Eviper01/MAX7000CPU-GEN3/S3-Kicad/S3_Schematic.html

# E:\Libraries\Documents\MAX7000CPU-GEN3\S3-Kicad\S3_Schematic.sch

9/11/2021 22:57:02

Eeschema (5.1.10)-1

Component Count:364

Ref | Qnty | Value | Part | Footprint | Description | Vendor
C1, C2 | 2 | 32p | Device:C | Capacitor_SMD:C_0805_2012Metric | Unpolarized capacitor
C3, C4, C5, C6, C7, C8, C9, C10, C11, C12, C13, C14, C15, C16, C17, C18, C19, C20, C21, C22, C23, C24, C25, C26, C27, C28, C29, C30, C31, C32, C33, C34, C35, C36, C37, C38, C39, C40, C41, C42, C43, C44, C45, C46, C47, C48, C49, C50, C51, C52, C53, C54, C55, C56, C57, C58, C59, C60, C61, C62, C63, C64, C65, C66, C67, C68, C69, C70, C71, C72, C73, C74, C75, C76, C77, C78 | 76 | 100n | Device:C | Capacitor_SMD:C_0805_2012Metric | Unpolarized capacitor
D1, D2, D3, D4, D5, D6, D7, D8, D9, D10, D11, D12, D13, D14, D15, D16, D17, D18, D19, D20, D21, D22, D23, D24, D25, D26, D27, D28, D29, D30, D31, D32, D33, D34, D35, D36, D37, D38, D39, D40, D41, D42, D43, D44, D45, D46, D47, D48, D49, D50, D51, D52, D53, D54, D55, D56 | 56 | LED | Device:LED | LED_SMD:LED_0805_2012Metric | Light emitting diode
J1 | 1 | Conn_02x04_Counter_Clockwise | Connector_Generic:Conn_02x04_Counter_Clockwise | Connector_PinHeader_2.54mm:PinHeader_2x04_P2.54mm_Vertical | Generic connector, double row, 02x04, counter clockwise pin numbering scheme (similar to DIP packge numbering), script generated (kicad-library-utils/schlib/autogen/connector/)
J2, J3, J11 | 3 | Conn_01x02 | Connector_Generic:Conn_01x02 | Connector_PinHeader_2.54mm:PinHeader_1x02_P2.54mm_Vertical | Generic connector, single row, 01x02, script generated (kicad-library-utils/schlib/autogen/connector/)
J4, J5 | 2 | Conn_01x04 | Connector_Generic:Conn_01x04 | Connector_PinHeader_2.54mm:PinHeader_1x04_P2.54mm_Vertical | Generic connector, single row, 01x04, script generated (kicad-library-utils/schlib/autogen/connector/)
J6 | 1 | Conn_01x03 | Connector_Generic:Conn_01x03 | Connector_PinHeader_2.54mm:PinHeader_1x03_P2.54mm_Vertical | Generic connector, single row, 01x03, script generated (kicad-library-utils/schlib/autogen/connector/)
J7 | 1 | Conn_02x16_Odd_Even | Connector_Generic:Conn_02x16_Odd_Even | Connector_PinHeader_2.54mm:PinHeader_2x16_P2.54mm_Vertical | Generic connector, double row, 02x16, odd/even pin numbering scheme (row 1 odd numbers, row 2 even numbers), script generated (kicad-library-utils/schlib/autogen/connector/)
J8, J9, J10 | 3 | Conn_01x16 | Connector_Generic:Conn_01x16 | Connector_PinHeader_2.54mm:PinHeader_1x16_P2.54mm_Vertical | Generic connector, single row, 01x16, script generated (kicad-library-utils/schlib/autogen/connector/)
R1, R2, R3, R4, R5, R6, R7, R8, R9, R10, R13, R14, R19, R20, R25, R26, R45, R46, R49, R50, R61, R64, R65, R66, R67, R68, R69, R70, R71, R72, R73, R74, R75, R76, R77, R78, R79, R80, R81, R82, R83, R84, R85, R86, R87, R88, R89, R100, R102, R103, R109, R110, R111, R112, R113, R114, R115, R116, R117, R118, R119, R120, R121, R122, R123, R124, R125, R126, R127, R128, R129, R130, R131, R132, R133, R134, R135, R136, R137, R138, R139, R140, R141, R142, R143, R144, R145, R146, R147, R148, R149, R150, R151, R152, R153 | 95 | 50K | Device:R | Resistor_SMD:R_0805_2012Metric | Resistor
R11 | 1 | 2.2M | Device:R | Resistor_SMD:R_0805_2012Metric | Resistor
R12 | 1 | 1k | Device:R | Resistor_SMD:R_0805_2012Metric | Resistor
R15, R16, R17, R18, R21, R22, R23, R24, R27, R28, R29, R30, R31, R32, R33, R34, R35, R36, R37, R38, R39, R40, R41, R42, R43, R44, R47, R48, R51, R52, R53, R54, R55, R56, R57, R58, R59, R60, R62, R63, R90, R91, R92, R93, R94, R95, R96, R97, R98, R99, R101, R104, R105, R106, R107, R108 | 56 | 330 | Device:R | Resistor_SMD:R_0805_2012Metric | Resistor
U1 | 1 | SN74LVC1GX04DCKR | Gen3Parts:SN74LVC1GX04DCKR | Package_TO_SOT_SMD:SOT-363_SC-70-6_Handsoldering | Crystal Oscillator Driver
U2, U4, U6, U8, U10, U13, U14, U15, U16, U22, U23, U28, U29, U47, U48, U49, U50, U51, U52, U53, U54, U55, U56, U57, U58, U59, U60, U61, U62 | 29 | 74HC541 | 74xx:74LS541 | Package_SO:TSSOP-20_4.4x6.5mm_P0.65mm | 8-bit Buffer/Line Driver 3-state outputs
U3, U5, U7, U9, U11, U31, U32, U33, U34, U35, U36, U37, U38, U39, U40, U41, U42, U43, U44, U45, U46 | 21 | 74HC574 | S3_Schematic-rescue:74LS573-74xx-MAX7000CPU-Gen2-rescue | Package_SO:TSSOP-20_4.4x6.5mm_P0.65mm
U12, U65 | 2 | SST39VF800A-70-4C-EKE | Gen3Parts:SST39VF800A-70-4C-EKE | Package_SO:TSOP-I-48_18.4x12mm_P0.5mm | 2.7 to 3.6V 8Mbit Multi-Purpose Flash
U17 | 1 | 74HC00 | 74xx:74HC00 | Package_SO:TSSOP-14_4.4x5mm_P0.65mm | quad 2-input NAND gate
U18, U19, U20, U21, U24, U25, U26, U27, U64 | 9 | 74hc193 | 74xx:74LS193 | Package_SO:TSSOP-16_4.4x5mm_P0.65mm | Synchronous 4-bit Up/Down (2 clk) counter
U30 | 1 | CY62136EV30LL-45ZSXI | Gen3Parts:CY62136EV30LL-45ZSXI | Package_SO:TSOP-II-44_10.16x18.41mm_P0.8mm | CYPRESS SEMICONDUCTOR - CY62136EV30LL-45ZSXI - IC, SRAM, 2 Mbit, 128K x 16bit, 45 ns Access Time, Parallel, 2.2 V to 3.6 V supply, TSOP-II-44
U63 | 1 | XC9572XL-10TQG100C | Gen3Parts:XC9572XL-10TQG100C | Package_QFP:TQFP-100_14x14mm_P0.5mm | XC9572XL-10TQG100C XC9572XL-10TQG100C, CPLD XC9500XL Flash 72 Cells, 72 I/O, 4 Labs, ISP, 3 3.6 V 100-Pin TQFP
Y1 | 1 | Crystal | Device:Crystal | Crystal:Crystal_HC49-U_Vertical | Two pin crystal
