Eviper01/MAX7000CPU-GEN3/Other/Digikey 3.3v parts.xlsx

Digikey CPU PARTS 3.3V
Name | Unit Price | Quantity | Total Cost | Link | Desc | Notes | Package | Pitch (mm) | Voltage
75HC574 | 0.532 | 25 | 13.3 | https://www.digikey.com.au/en/products/detail/nexperia-usa-inc/74HC574PW-118/1230481 | 8 Bit Register |  | TSSOP-20 | 0.65 | 2 - 6 V | Total | 51.146
74HC541 | 0.492 | 25 | 12.3 | https://www.digikey.com.au/en/products/detail/nexperia-usa-inc/74HC541PW-118/1230470 | 8 Bit Buffer |  | TSSOP-20 | 0.65 | 2 - 6 V
74HC193 | 0.662 | 8 | 5.296 | https://www.digikey.com.au/en/products/detail/texas-instruments/SN74HC193PWR/1570826 | 4 Bit Presetable Up/Down Counter | Lots of Options for this Chip | TSSOP-16 | 0.65 | 2 - 6 V
CY62136EV30LL | 1.59 | 1 | 1.59 | https://www.digikey.com.au/en/products/detail/cypress-semiconductor-corp/CY62136EV30LL-45ZSXIT/1543737 | 128K x 16 SRAM | Amazing chip | TSSOP-44 II | 0.8 | 2.2 - 3.6 V
SST39VF800A | 3.47 | 3 | 10.41 | https://www.digikey.com.au/en/products/detail/microchip-technology/SST39VF800A-70-4C-EKE-T/2299416 | 512K x 16 Flash |  | TFSOP-48 | 0.5 | 2.7 - 3.6 V
SN74LVC1GX04DCKR | 1.52 | 1 | 1.52 | https://www.digikey.com.au/en/products/detail/texas-instruments/SN74LVC1GX04DCKR/701979 | Crystal Driver | bruh oscillators are hard | TSSOP-6 | 0.65 | 1.65 - 5.5 V
XC9572XL-10TQG100C | 6.73 | 1 | 6.73 | https://www.digikey.com.au/en/products/detail/xilinx-inc/XC9572XL-10VQG64C/826991 | Xilinx CPLD 72 I/O | need progamming circuitry | TQFP-100 | 0.50 | 3 -3.6 V
USB serial controller |  |  |  | https://www.digikey.com.au/en/products/detail/ftdi-future-technology-devices-international-ltd/FT245RL-REEL/1836389
4 nand gates L |  |  |  | https://www.digikey.com.au/en/products/detail/diodes-incorporated/74HC00T14-13/4249391 |  |  |  | 0.56
 |  |  |  | https://www.digikey.com.au/en/products/detail/onsemi/MC74HC00ADTR2G/1479812 |  |  |  | 0.92
SMD Resistors (Aliexpress)
SMD LEDs (Aliexpress)
SMD Capacitors (Aliexpress)
Crystals
