Eviper01/MAX7000CPU-GEN3/Other/DIGIKEY PARTS.xlsx

Digikey CPU PARTS
Name | Unit Price | Quantity | Total Cost | Link | Desc | Notes | Package | Pitch
75HC574 | 0.5328 | 25 | 13.32 | https://www.digikey.com.au/en/products/detail/nexperia-usa-inc/74HC574PW-118/1230481 | 8 Bit Register |  | TSSOP-20 | 0.65 | Total | 62.55
74HC541 | 0.492 | 25 | 12.3 | https://www.digikey.com.au/en/products/detail/nexperia-usa-inc/74HC541PW-118/1230470 | 8 Bit Buffer |  | TSSOP-20 | 0.65
74HC193 | 0.662 | 15 | 9.93 | https://www.digikey.com.au/en/products/detail/texas-instruments/SN74HC193PWR/1570826 | 4 Bit Presetable Up/Down Counter | Lots of Options for this Chip | TSSOP-16 | 0.65
CY62128ELL | 2.96 | 3 | 8.88 | https://www.digikey.com.au/en/products/detail/cypress-semiconductor-corp/CY62128ELL-55ZAXET/1839122 | 128K x 8 RAM | Serveral Choices for Ram | TSSOP-32 | 0.65
NE555 | 0.547 | 10 | 5.47 | https://www.digikey.com.au/en/products/detail/texas-instruments/NE555PWR/1571970 | Clock/Timer/Debounce | Backorder | TSSOP-8 | 0.65
SST39SF040 | 2.53 | 5 | 12.65 | https://www.digikey.com.au/en/products/detail/microchip-technology/SST39SF040-70-4C-WHE/2297836 | 512k x 8 FLASH | Pitch Seems to be lower | TFSOP-32 | 0.50
 |  |  | 0
EPM7128 (Ebay) |  |  | 0
SMD Resistors (Aliexpress) |  |  | 0
SMD LEDs (Aliexpress) |  |  | 0
SMD Capacitors (Aliexpress) |  |  | 0
Buttons (Aliexpress |  |  | 0
 |  |  | 0
 |  |  | 0
 |  |  | 0
 |  |  | 0
 |  |  | 0
 |  |  | 0
 |  |  | 0
 |  |  | 0
 |  |  | 0
 |  |  | 0
