Eviper01/MAX7000CPU-GEN3/Other/logo.dxf

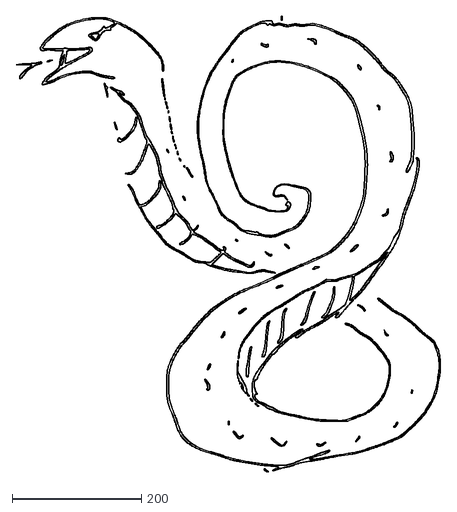
[picture p1: CAD file, 2021-10-10]
Other/logo.dxf
656.7 x 706.0
