Eviper01/MAX7000CPU-GEN3/(list of files, drawings)

Other design files:
S3-Kicad/S3_Schematic.dsn
