Eviper01/MAX7000CPU-GEN3/S3-Kicad/S3_Schematic.kicad_pcb

## KiCad design S3-Kicad/S3_Schematic.kicad_pcb (2021-11-12)

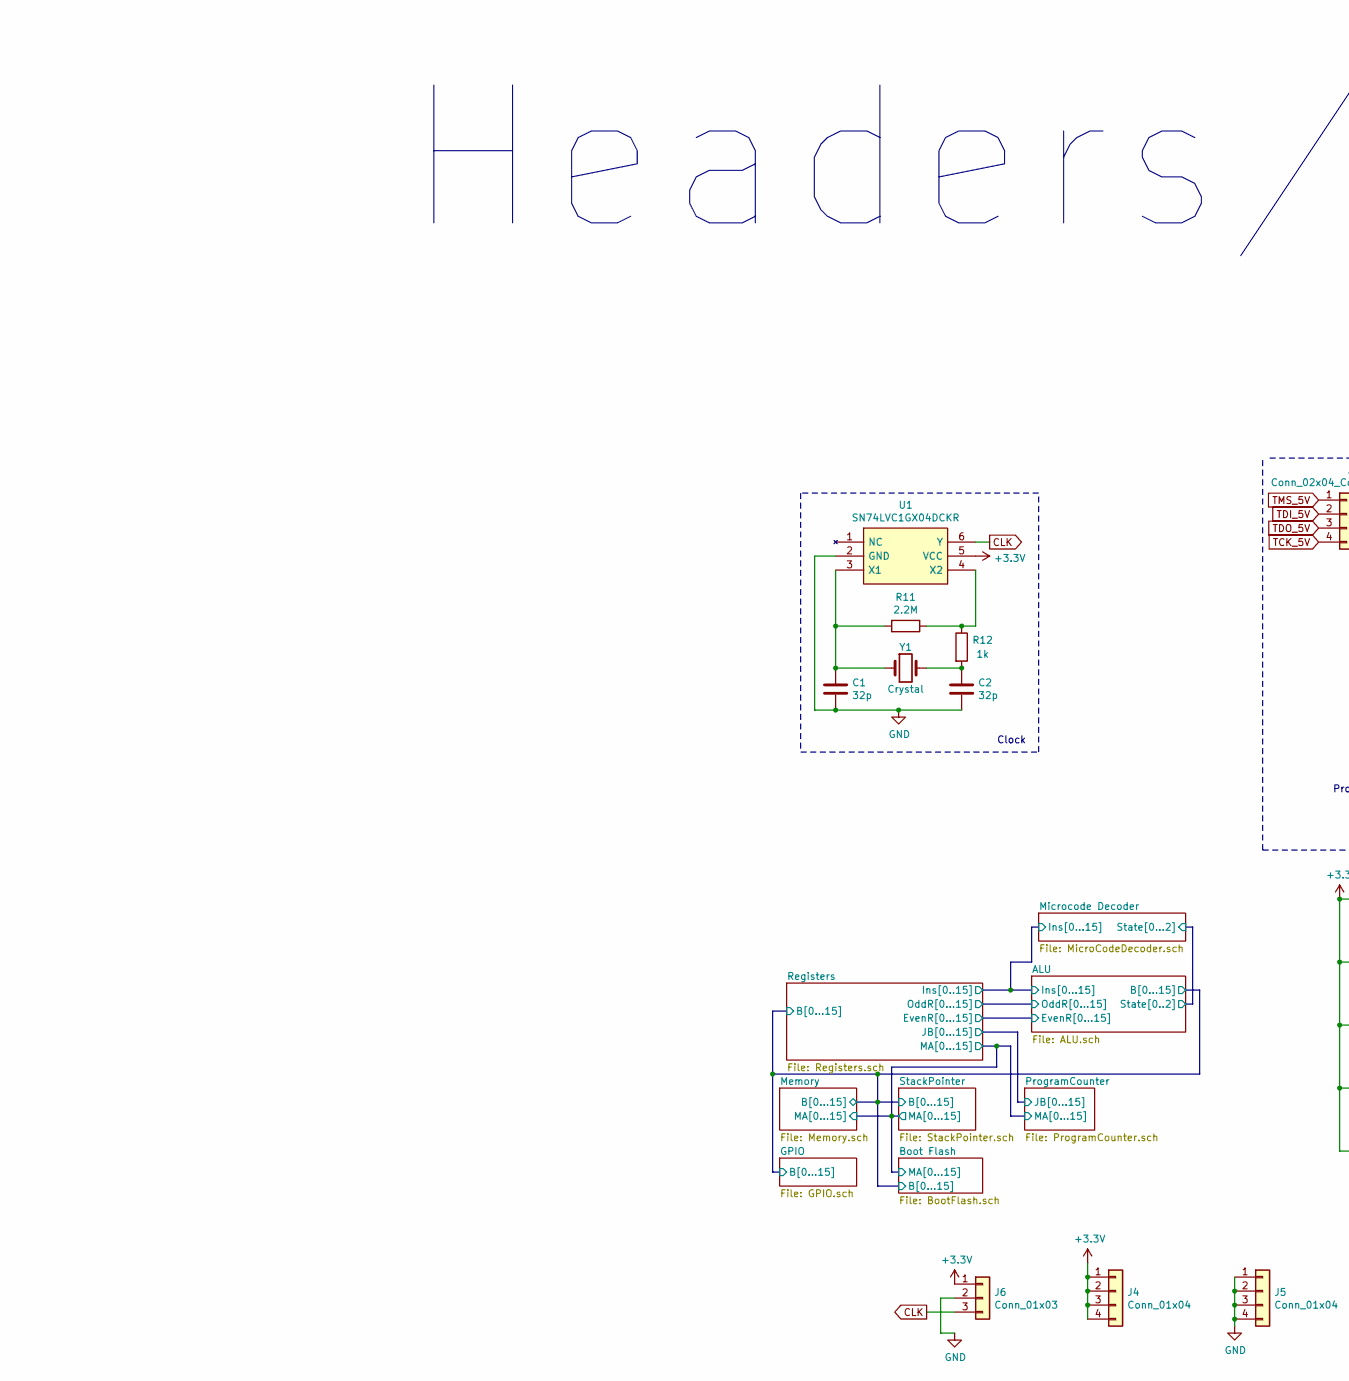
[picture p2: schematic S3_Schematic.sch, part in row 1, column 1]

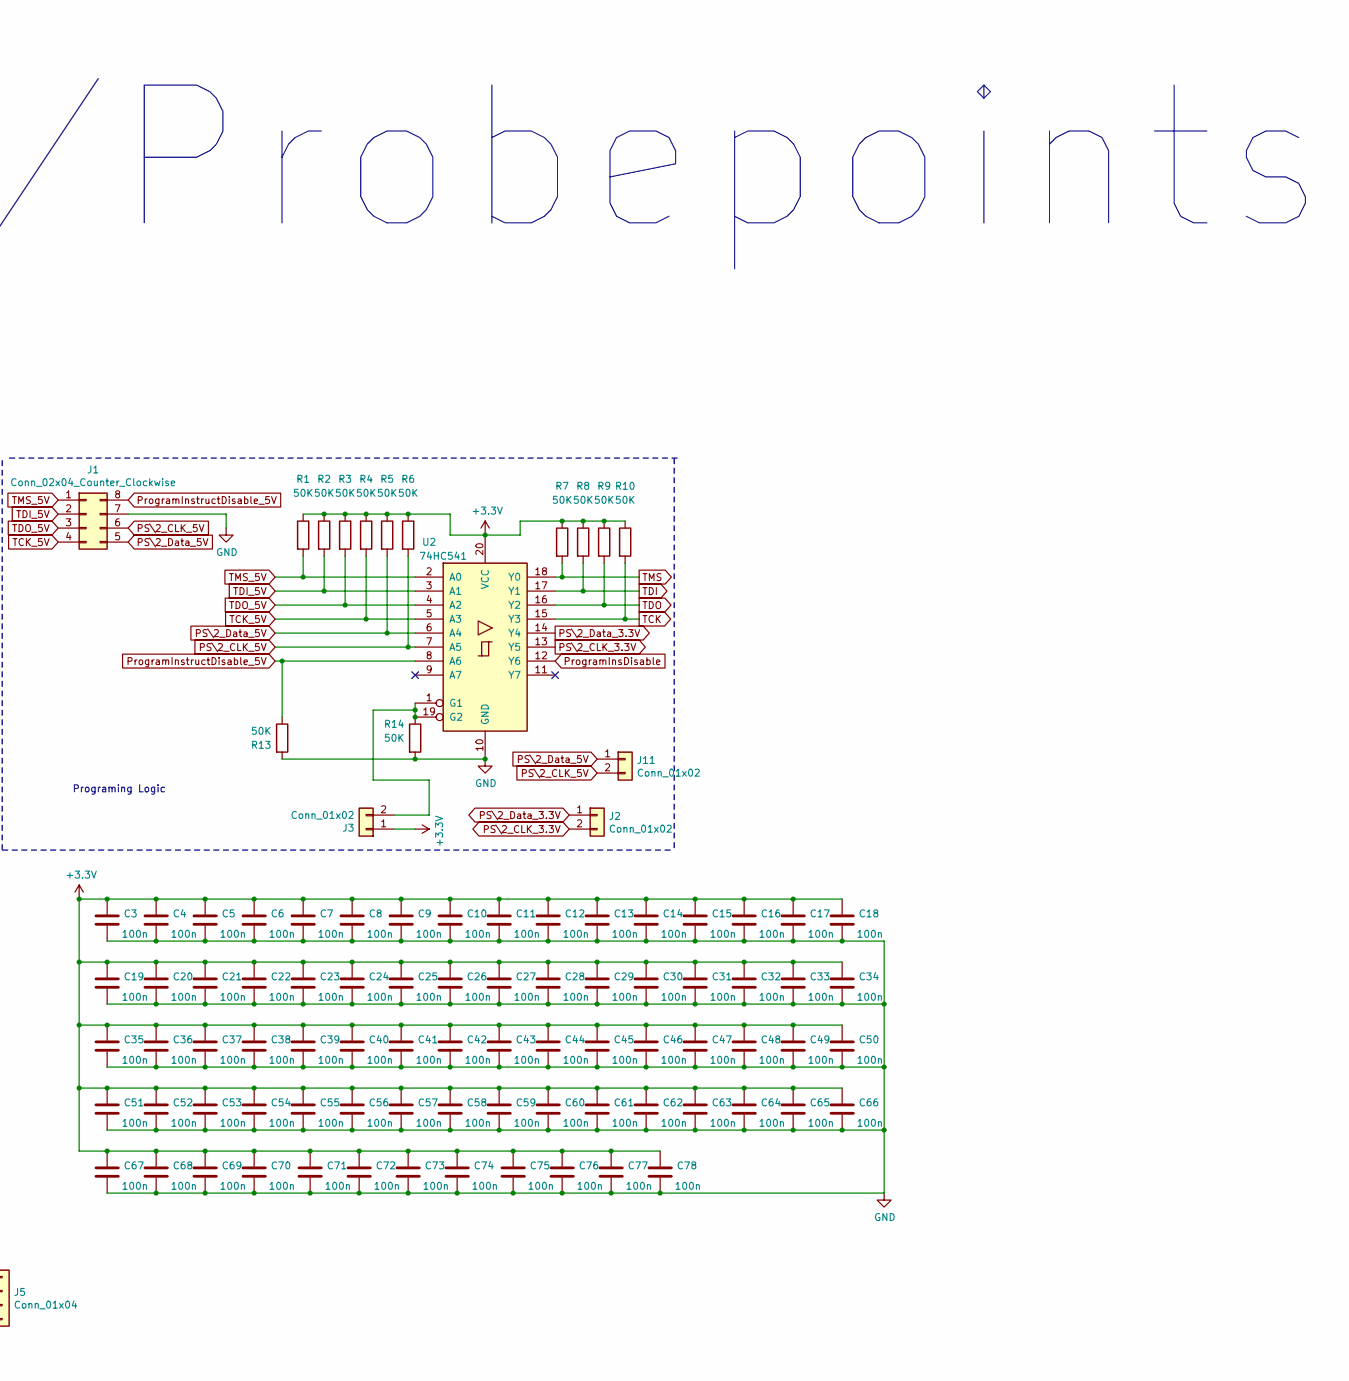
[picture p3: schematic S3_Schematic.sch, part in row 1, column 2]

Parts:
C1, C2: 32p; C_0805_2012Metric
C3, C4, C5, C6, C7, C8, C9, C10, C11, C12, C13, C14, C15, C16, C17, C18, C19, C20, C21, C22, C23, C24, C25, C26, C27, C28, C29, C30, C31, C32, C33, C34, C35, C36, C37, C38, C39, C40, C41, C42, C43, C44, C45, C46, C47, C48, C49, C50, C51, C52, C53, C54, C55, C56, C57, C58, C59, C60, C61, C62, C63, C64, C65, C66, C67, C68, C69, C70, C71, C72, C73, C74, C75, C76, C77, C78: 100n; C_0805_2012Metric
J1: Conn_02x04_Counter_Clockwise; PinHeader_2x04_P2.54mm_Vertical
J2, J3, J11: Conn_01x02; PinHeader_1x02_P2.54mm_Vertical
J4, J5: Conn_01x04; PinHeader_1x04_P2.54mm_Vertical
J6: Conn_01x03; PinHeader_1x03_P2.54mm_Vertical
R1, R2, R3, R4, R5, R6, R7, R8, R9, R10, R13, R14: 50K; R_0805_2012Metric
R11: 2.2M; R_0805_2012Metric
R12: 1k; R_0805_2012Metric
U1: SN74LVC1GX04DCKR; SOT-363_SC-70-6_Handsoldering; Mouser Part Number 595-SN74LVC1GX04DCKR
U2: 74HC541; TSSOP-20_4.4x6.5mm_P0.65mm
Y1: Crystal; Crystal_HC49-U_Vertical

Connections:
+3V3: C3.1, C4.1, C5.1, C6.1, C7.1, C8.1, C9.1, C10.1, C11.1, C12.1, C13.1, C14.1, C15.1, C16.1, C17.1, C18.1, C19.1, C20.1, C21.1, C22.1, C23.1, C24.1, C25.1, C26.1, C27.1, C28.1, C29.1, C30.1, C31.1, C32.1, C33.1, C34.1, C35.1, C36.1, C37.1, C38.1, C39.1, C40.1, C41.1, C42.1, C43.1, C44.1, C45.1, C46.1, C47.1, C48.1, C49.1, C50.1, C51.1, C52.1, C53.1, C54.1, C55.1, C56.1, C57.1, C58.1, C59.1, C60.1, C61.1, C62.1, C63.1, C64.1, C65.1, C66.1, C67.1, C68.1, C69.1, C70.1, C71.1, C72.1, C73.1, C74.1, C75.1, C76.1, C77.1, C78.1, J3.1, J4.1, J4.2, J4.3, J4.4, J6.1, R1.1, R2.1, R3.1, R4.1, R5.1, R6.1, R7.1, R8.1, R9.1, R10.1, U1.5 (VCC), U2.20 (VCC); also elsewhere on the board
CLK: J6.3, U1.6 (Y); also elsewhere on the board
GND: C1.2, C2.2, C3.2, C4.2, C5.2, C6.2, C7.2, C8.2, C9.2, C10.2, C11.2, C12.2, C13.2, C14.2, C15.2, C16.2, C17.2, C18.2, C19.2, C20.2, C21.2, C22.2, C23.2, C24.2, C25.2, C26.2, C27.2, C28.2, C29.2, C30.2, C31.2, C32.2, C33.2, C34.2, C35.2, C36.2, C37.2, C38.2, C39.2, C40.2, C41.2, C42.2, C43.2, C44.2, C45.2, C46.2, C47.2, C48.2, C49.2, C50.2, C51.2, C52.2, C53.2, C54.2, C55.2, C56.2, C57.2, C58.2, C59.2, C60.2, C61.2, C62.2, C63.2, C64.2, C65.2, C66.2, C67.2, C68.2, C69.2, C70.2, C71.2, C72.2, C73.2, C74.2, C75.2, C76.2, C77.2, C78.2, J1.7, J5.1, J5.2, J5.3, J5.4, J6.2, R13.2, R14.2, U1.2 (GND), U2.10 (GND); also elsewhere on the board
unnamed: C1.1, R11.2, U1.3 (X1), Y1.1
unnamed: C2.1, R12.2, Y1.2
unnamed: J3.2, R14.1, U2.1 (G1), U2.19 (G2)
unnamed: R11.1, R12.1, U1.4 (X2)
PS\2_CLK_3.3V: J2.2, U2.13 (Y5); also elsewhere on the board
PS\2_CLK_5V: J1.6, J11.2, R6.2, U2.7 (A5)
PS\2_Data_3.3V: J2.1, U2.14 (Y4); also elsewhere on the board
PS\2_Data_5V: J1.5, J11.1, R5.2, U2.6 (A4)
ProgramInsDisable: U2.12 (Y6); also elsewhere on the board
ProgramInstructDisable_5V: J1.8, R13.1, U2.8 (A6)
TCK: R10.2, U2.15 (Y3); also elsewhere on the board
TCK_5V: J1.4, R4.2, U2.5 (A3)
TDI: R8.2, U2.17 (Y1); also elsewhere on the board
TDI_5V: J1.2, R2.2, U2.3 (A1)
TDO: R9.2, U2.16 (Y2); also elsewhere on the board
TDO_5V: J1.3, R3.2, U2.4 (A2)
TMS: R7.2, U2.18 (Y0); also elsewhere on the board
TMS_5V: J1.1, R1.2, U2.2 (A0)

Notes on the sheet:
Headers/Probepoints
Clock
Programing Logic

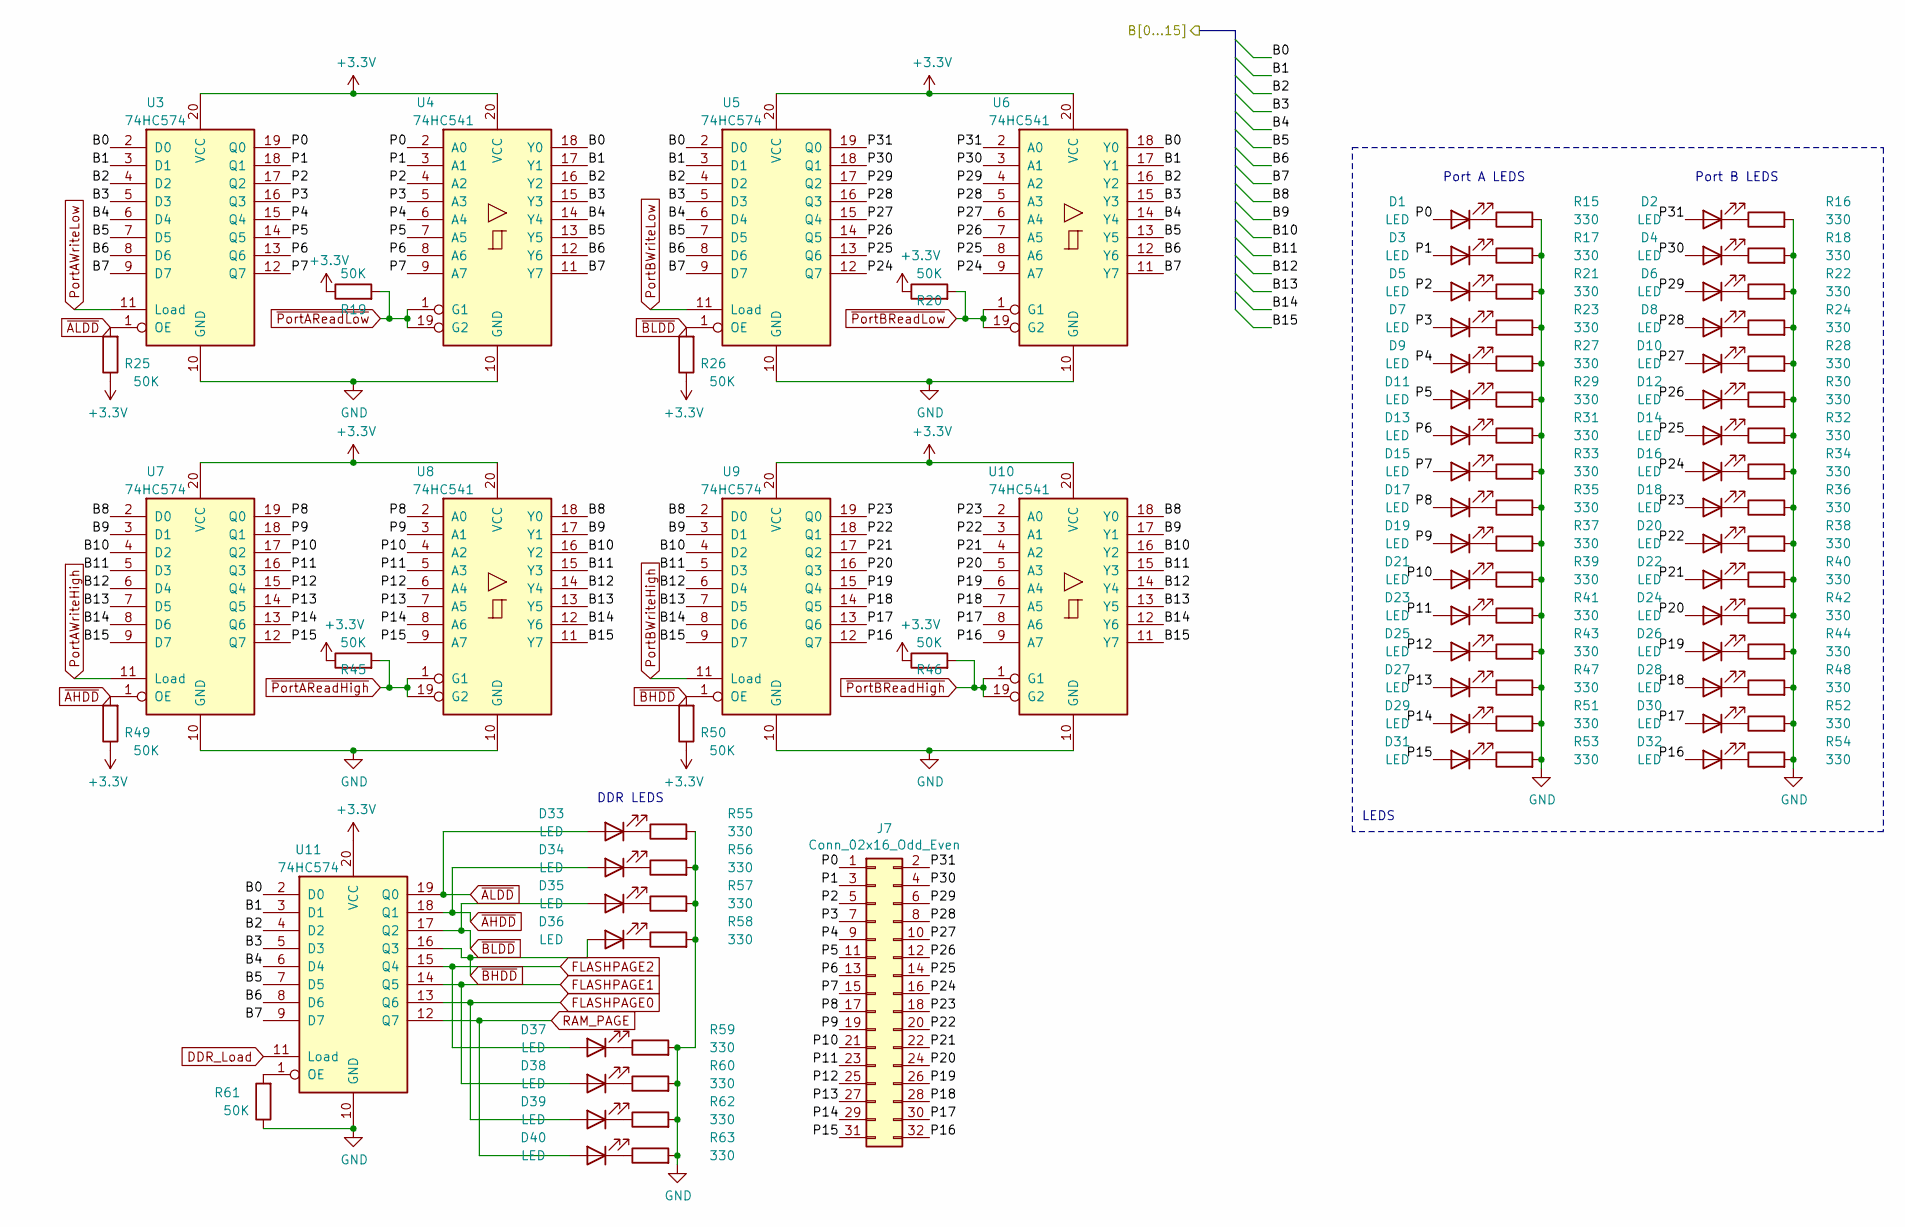
[picture p4: schematic GPIO.sch]

Parts:
D1, D2, D3, D4, D5, D6, D7, D8, D9, D10, D11, D12, D13, D14, D15, D16, D17, D18, D19, D20, D21, D22, D23, D24, D25, D26, D27, D28, D29, D30, D31, D32, D33, D34, D35, D36, D37, D38, D39, D40: LED; LED_0805_2012Metric
J7: Conn_02x16_Odd_Even; PinHeader_2x16_P2.54mm_Vertical
R15, R16, R17, R18, R21, R22, R23, R24, R27, R28, R29, R30, R31, R32, R33, R34, R35, R36, R37, R38, R39, R40, R41, R42, R43, R44, R47, R48, R51, R52, R53, R54, R55, R56, R57, R58, R59, R60, R62, R63: 330; R_0805_2012Metric
R19, R20, R25, R26, R45, R46, R49, R50, R61: 50K; R_0805_2012Metric
U3, U5, U7, U9, U11: 74HC574; TSSOP-20_4.4x6.5mm_P0.65mm
U4, U6, U8, U10: 74HC541; TSSOP-20_4.4x6.5mm_P0.65mm

Connections:
+3V3: R19.1, R20.1, R25.1, R26.1, R45.1, R46.1, R49.1, R50.1, U3.20 (VCC), U4.20 (VCC), U5.20 (VCC), U6.20 (VCC), U7.20 (VCC), U8.20 (VCC), U9.20 (VCC), U10.20 (VCC), U11.20 (VCC); also elsewhere on the board
/ALU/B0: U3.2 (D0), U4.18 (Y0), U5.2 (D0), U6.18 (Y0), U11.2 (D0); also elsewhere on the board
/ALU/B1: U3.3 (D1), U4.17 (Y1), U5.3 (D1), U6.17 (Y1), U11.3 (D1); also elsewhere on the board
/ALU/B2: U3.4 (D2), U4.16 (Y2), U5.4 (D2), U6.16 (Y2), U11.4 (D2); also elsewhere on the board
/ALU/B3: U3.5 (D3), U4.15 (Y3), U5.5 (D3), U6.15 (Y3), U11.5 (D3); also elsewhere on the board
/ALU/B4: U3.6 (D4), U4.14 (Y4), U5.6 (D4), U6.14 (Y4), U11.6 (D4); also elsewhere on the board
/ALU/B5: U3.7 (D5), U4.13 (Y5), U5.7 (D5), U6.13 (Y5), U11.7 (D5); also elsewhere on the board
/ALU/B6: U3.8 (D6), U4.12 (Y6), U5.8 (D6), U6.12 (Y6), U11.8 (D6); also elsewhere on the board
/ALU/B7: U3.9 (D7), U4.11 (Y7), U5.9 (D7), U6.11 (Y7), U11.9 (D7); also elsewhere on the board
/ALU/B8: U7.2 (D0), U8.18 (Y0), U9.2 (D0), U10.18 (Y0); also elsewhere on the board
/ALU/B9: U7.3 (D1), U8.17 (Y1), U9.3 (D1), U10.17 (Y1); also elsewhere on the board
/ALU/B10: U7.4 (D2), U8.16 (Y2), U9.4 (D2), U10.16 (Y2); also elsewhere on the board
/ALU/B11: U7.5 (D3), U8.15 (Y3), U9.5 (D3), U10.15 (Y3); also elsewhere on the board
/ALU/B12: U7.6 (D4), U8.14 (Y4), U9.6 (D4), U10.14 (Y4); also elsewhere on the board
/ALU/B13: U7.7 (D5), U8.13 (Y5), U9.7 (D5), U10.13 (Y5); also elsewhere on the board
/ALU/B14: U7.8 (D6), U8.12 (Y6), U9.8 (D6), U10.12 (Y6); also elsewhere on the board
/ALU/B15: U7.9 (D7), U8.11 (Y7), U9.9 (D7), U10.11 (Y7); also elsewhere on the board
/GPIO/P0: D1.2 (A), J7.1, U3.19 (Q0), U4.2 (A0)
/GPIO/P1: D3.2 (A), J7.3, U3.18 (Q1), U4.3 (A1)
/GPIO/P2: D5.2 (A), J7.5, U3.17 (Q2), U4.4 (A2)
/GPIO/P3: D7.2 (A), J7.7, U3.16 (Q3), U4.5 (A3)
/GPIO/P4: D9.2 (A), J7.9, U3.15 (Q4), U4.6 (A4)
/GPIO/P5: D11.2 (A), J7.11, U3.14 (Q5), U4.7 (A5)
/GPIO/P6: D13.2 (A), J7.13, U3.13 (Q6), U4.8 (A6)
/GPIO/P7: D15.2 (A), J7.15, U3.12 (Q7), U4.9 (A7)
/GPIO/P8: D17.2 (A), J7.17, U7.19 (Q0), U8.2 (A0)
/GPIO/P9: D19.2 (A), J7.19, U7.18 (Q1), U8.3 (A1)
/GPIO/P10: D21.2 (A), J7.21, U7.17 (Q2), U8.4 (A2)
/GPIO/P11: D23.2 (A), J7.23, U7.16 (Q3), U8.5 (A3)
/GPIO/P12: D25.2 (A), J7.25, U7.15 (Q4), U8.6 (A4)
/GPIO/P13: D27.2 (A), J7.27, U7.14 (Q5), U8.7 (A5)
/GPIO/P14: D29.2 (A), J7.29, U7.13 (Q6), U8.8 (A6)
/GPIO/P15: D31.2 (A), J7.31, U7.12 (Q7), U8.9 (A7)
/GPIO/P16: D32.2 (A), J7.32, U9.12 (Q7), U10.9 (A7)
/GPIO/P17: D30.2 (A), J7.30, U9.13 (Q6), U10.8 (A6)
/GPIO/P18: D28.2 (A), J7.28, U9.14 (Q5), U10.7 (A5)
/GPIO/P19: D26.2 (A), J7.26, U9.15 (Q4), U10.6 (A4)
/GPIO/P20: D24.2 (A), J7.24, U9.16 (Q3), U10.5 (A3)
/GPIO/P21: D22.2 (A), J7.22, U9.17 (Q2), U10.4 (A2)
/GPIO/P22: D20.2 (A), J7.20, U9.18 (Q1), U10.3 (A1)
/GPIO/P23: D18.2 (A), J7.18, U9.19 (Q0), U10.2 (A0)
/GPIO/P24: D16.2 (A), J7.16, U5.12 (Q7), U6.9 (A7)
/GPIO/P25: D14.2 (A), J7.14, U5.13 (Q6), U6.8 (A6)
/GPIO/P26: D12.2 (A), J7.12, U5.14 (Q5), U6.7 (A5)
/GPIO/P27: D10.2 (A), J7.10, U5.15 (Q4), U6.6 (A4)
/GPIO/P28: D8.2 (A), J7.8, U5.16 (Q3), U6.5 (A3)
/GPIO/P29: D6.2 (A), J7.6, U5.17 (Q2), U6.4 (A2)
/GPIO/P30: D4.2 (A), J7.4, U5.18 (Q1), U6.3 (A1)
/GPIO/P31: D2.2 (A), J7.2, U5.19 (Q0), U6.2 (A0)
DDR_Load: U11.11 (Load); also elsewhere on the board
FLASHPAGE0: D39.2 (A), U11.13 (Q6); also elsewhere on the board
FLASHPAGE1: D38.2 (A), U11.14 (Q5); also elsewhere on the board
FLASHPAGE2: D37.2 (A), U11.15 (Q4); also elsewhere on the board
GND: R15.2, R16.2, R17.2, R18.2, R21.2, R22.2, R23.2, R24.2, R27.2, R28.2, R29.2, R30.2, R31.2, R32.2, R33.2, R34.2, R35.2, R36.2, R37.2, R38.2, R39.2, R40.2, R41.2, R42.2, R43.2, R44.2, R47.2, R48.2, R51.2, R52.2, R53.2, R54.2, R55.2, R56.2, R57.2, R58.2, R59.2, R60.2, R61.1, R62.2, R63.2, U3.10 (GND), U4.10 (GND), U5.10 (GND), U6.10 (GND), U7.10 (GND), U8.10 (GND), U9.10 (GND), U10.10 (GND), U11.10 (GND); also elsewhere on the board
unnamed: D1.1 (K), R15.1
unnamed: D2.1 (K), R16.1
unnamed: D3.1 (K), R17.1
unnamed: D4.1 (K), R18.1
unnamed: D5.1 (K), R21.1
unnamed: D6.1 (K), R22.1
unnamed: D7.1 (K), R23.1
unnamed: D8.1 (K), R24.1
unnamed: D9.1 (K), R27.1
unnamed: D10.1 (K), R28.1
unnamed: D11.1 (K), R29.1
unnamed: D12.1 (K), R30.1
unnamed: D13.1 (K), R31.1
unnamed: D14.1 (K), R32.1
unnamed: D15.1 (K), R33.1
unnamed: D16.1 (K), R34.1
unnamed: D17.1 (K), R35.1
unnamed: D18.1 (K), R36.1
unnamed: D19.1 (K), R37.1
unnamed: D20.1 (K), R38.1
unnamed: D21.1 (K), R39.1
unnamed: D22.1 (K), R40.1
unnamed: D23.1 (K), R41.1
unnamed: D24.1 (K), R42.1
unnamed: D25.1 (K), R43.1
unnamed: D26.1 (K), R44.1
unnamed: D27.1 (K), R47.1
unnamed: D28.1 (K), R48.1
unnamed: D29.1 (K), R51.1
unnamed: D30.1 (K), R52.1
unnamed: D31.1 (K), R53.1
unnamed: D32.1 (K), R54.1
unnamed: D33.1 (K), R55.1
unnamed: D34.1 (K), R56.1
unnamed: D35.1 (K), R57.1
unnamed: D36.1 (K), R58.1
unnamed: D37.1 (K), R59.1
unnamed: D38.1 (K), R60.1
unnamed: D39.1 (K), R62.1
unnamed: D40.1 (K), R63.1
unnamed: R61.2, U11.1 (OE)
PortAWriteHigh: U7.11 (Load); also elsewhere on the board
PortAWriteLow: U3.11 (Load); also elsewhere on the board
PortBWriteHigh: U9.11 (Load); also elsewhere on the board
PortBWriteLow: U5.11 (Load); also elsewhere on the board
RAM_PAGE: D40.2 (A), U11.12 (Q7); also elsewhere on the board
~AHDD: D34.2 (A), R49.2, U7.1 (OE), U11.18 (Q1)
~ALDD: D33.2 (A), R25.2, U3.1 (OE), U11.19 (Q0)
~BHDD: D36.2 (A), R50.2, U9.1 (OE), U11.16 (Q3)
~BLDD: D35.2 (A), R26.2, U5.1 (OE), U11.17 (Q2)
~PortAReadHigh: R45.2, U8.1 (G1), U8.19 (G2); also elsewhere on the board
~PortAReadLow: R19.2, U4.1 (G1), U4.19 (G2); also elsewhere on the board
~PortBReadHigh: R46.2, U10.1 (G1), U10.19 (G2); also elsewhere on the board
~PortBReadLow: R20.2, U6.1 (G1), U6.19 (G2); also elsewhere on the board

Notes on the sheet:
DDR LEDS
Port B LEDS
Port A LEDS
LEDS

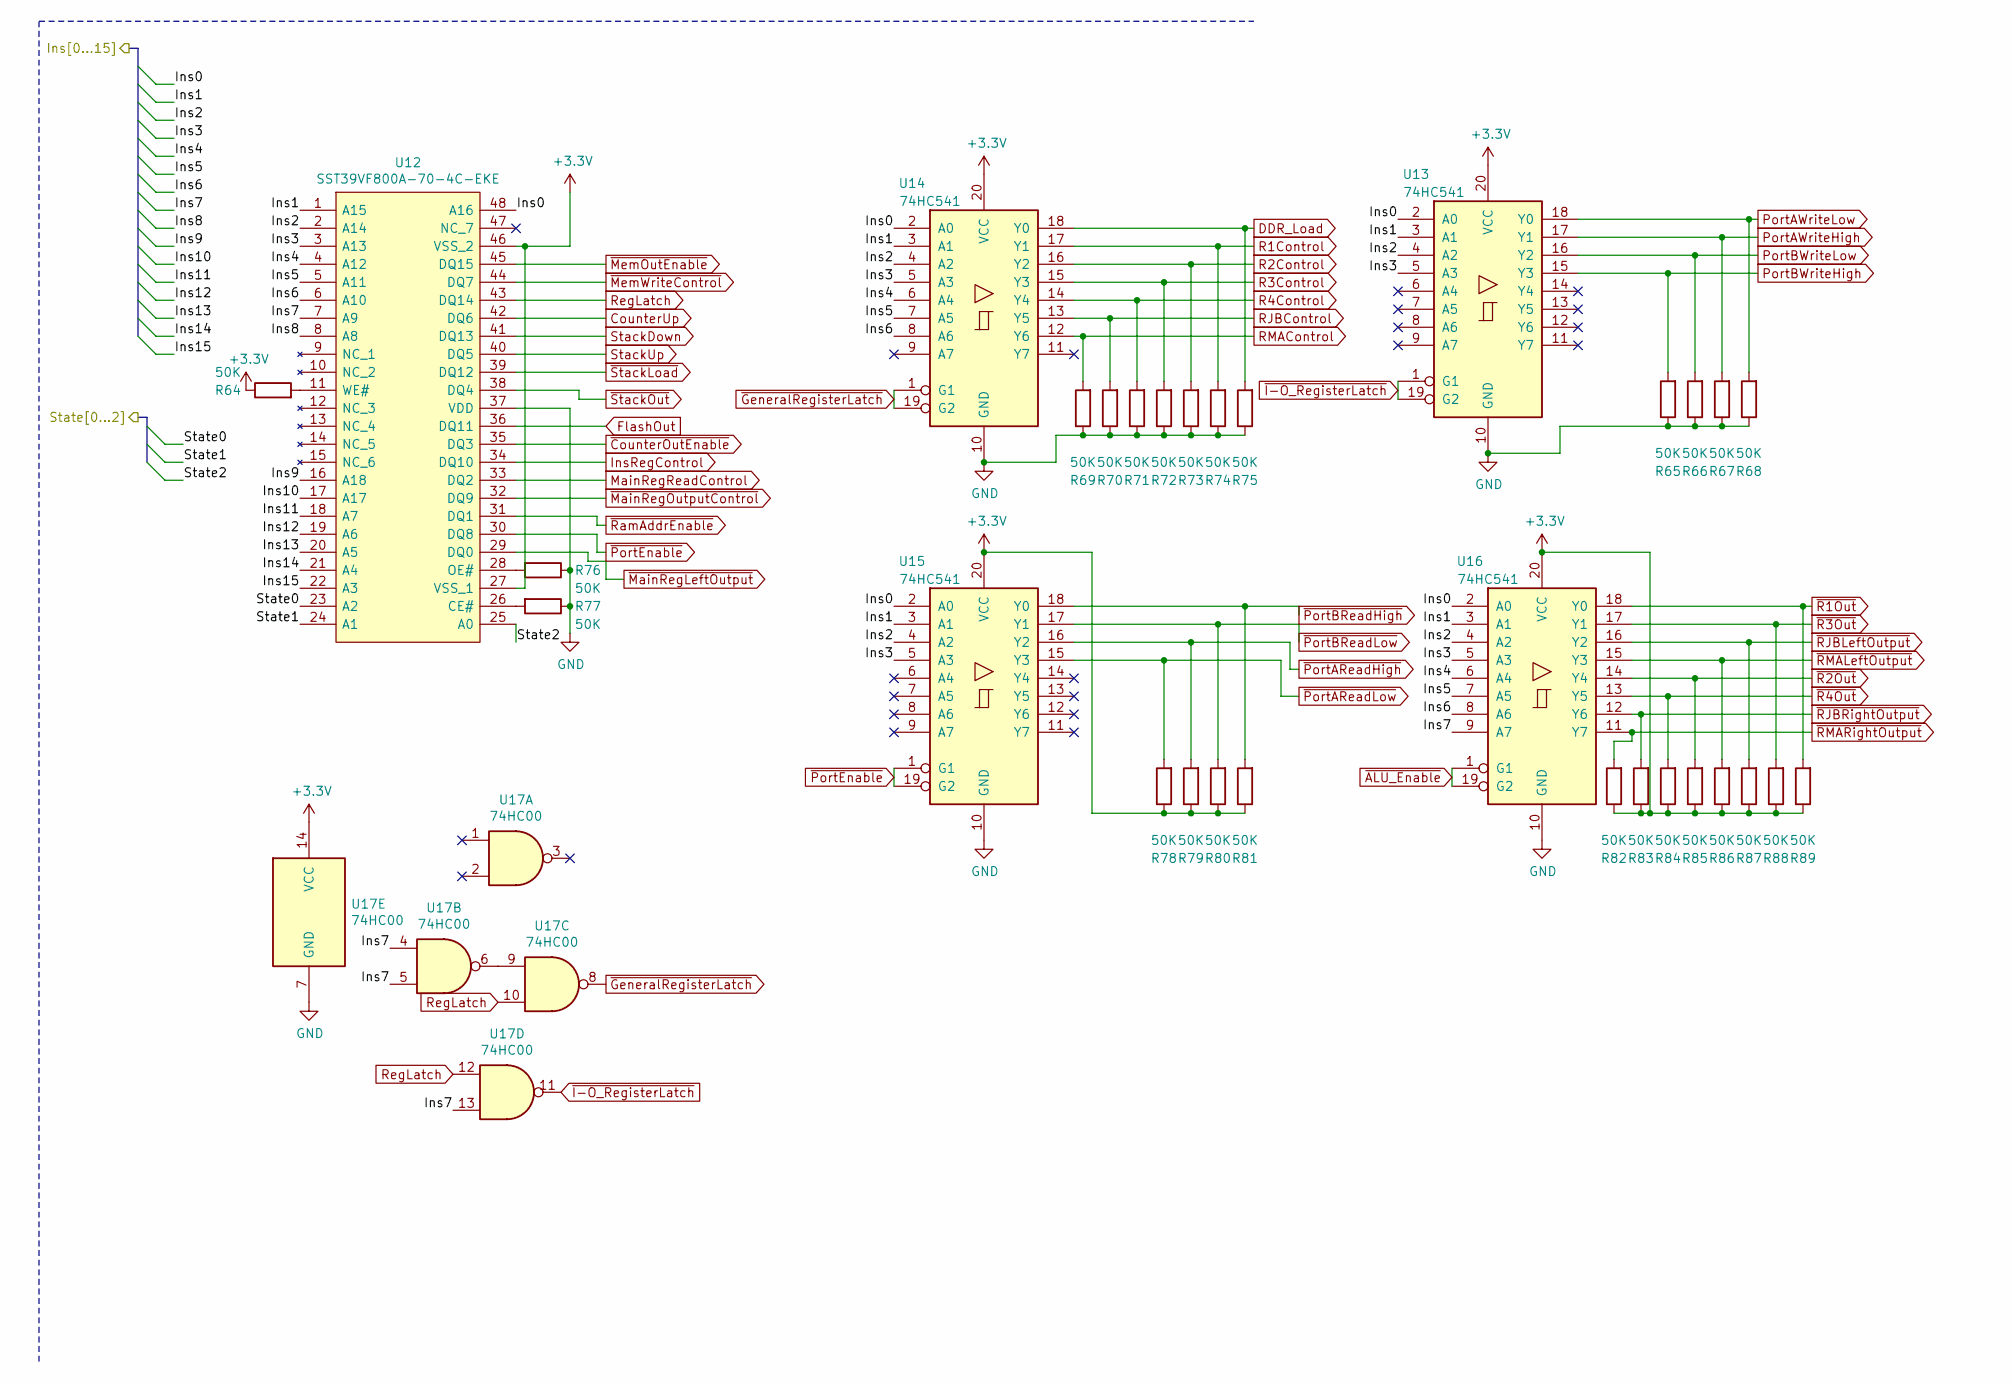
[picture p5: schematic MicroCodeDecoder.sch]

Parts:
R64, R65, R66, R67, R68, R69, R70, R71, R72, R73, R74, R75, R76, R77, R78, R79, R80, R81, R82, R83, R84, R85, R86, R87, R88, R89: 50K; R_0805_2012Metric
U12: SST39VF800A-70-4C-EKE; TSOP-I-48_18.4x12mm_P0.5mm; Mouser Part Number 804-39VF800A7CEKE
U13, U14, U15, U16: 74HC541; TSSOP-20_4.4x6.5mm_P0.65mm
U17: 74HC00; TSSOP-14_4.4x5mm_P0.65mm

Connections:
+3V3: R64.1, R78.1, R79.1, R80.1, R81.1, R82.1, R83.1, R84.1, R85.1, R86.1, R87.1, R88.1, R89.1, U12.27 (VSS_1), U12.46 (VSS_2), U13.20 (VCC), U14.20 (VCC), U15.20 (VCC), U16.20 (VCC), U17.14 (VCC); also elsewhere on the board
/ALU/Ins0: U12.48 (A16), U13.2 (A0), U14.2 (A0), U15.2 (A0), U16.2 (A0); also elsewhere on the board
/ALU/Ins1: U12.1 (A15), U13.3 (A1), U14.3 (A1), U15.3 (A1), U16.3 (A1); also elsewhere on the board
/ALU/Ins2: U12.2 (A14), U13.4 (A2), U14.4 (A2), U15.4 (A2), U16.4 (A2); also elsewhere on the board
/ALU/Ins3: U12.3 (A13), U13.5 (A3), U14.5 (A3), U15.5 (A3), U16.5 (A3); also elsewhere on the board
/ALU/Ins4: U12.4 (A12), U14.6 (A4), U16.6 (A4); also elsewhere on the board
/ALU/Ins5: U12.5 (A11), U14.7 (A5), U16.7 (A5); also elsewhere on the board
/ALU/Ins6: U12.6 (A10), U14.8 (A6), U16.8 (A6); also elsewhere on the board
/ALU/Ins7: U12.7 (A9), U16.9 (A7), U17.4, U17.5, U17.13; also elsewhere on the board
/ALU/Ins8: U12.8 (A8); also elsewhere on the board
/ALU/Ins9: U12.16 (A18); also elsewhere on the board
/ALU/Ins10: U12.17 (A17); also elsewhere on the board
/ALU/Ins11: U12.18 (A7); also elsewhere on the board
/ALU/Ins12: U12.19 (A6); also elsewhere on the board
/ALU/Ins13: U12.20 (A5); also elsewhere on the board
/ALU/Ins14: U12.21 (A4); also elsewhere on the board
/ALU/Ins15: U12.22 (A3); also elsewhere on the board
/ALU/State0: U12.23 (A2); also elsewhere on the board
/ALU/State1: U12.24 (A1); also elsewhere on the board
/ALU/State2: U12.25 (A0); also elsewhere on the board
CounterUp: U12.42 (DQ6); also elsewhere on the board
DDR_Load: R75.2, U14.18 (Y0); also elsewhere on the board
FlashOut: U12.36 (DQ11); also elsewhere on the board
GND: R65.1, R66.1, R67.1, R68.1, R69.1, R70.1, R71.1, R72.1, R73.1, R74.1, R75.1, R76.1, R77.1, U12.37 (VDD), U13.10 (GND), U14.10 (GND), U15.10 (GND), U16.10 (GND), U17.7 (GND); also elsewhere on the board
InsRegControl: U12.34 (DQ10); also elsewhere on the board
MainRegReadControl: U12.33 (DQ2); also elsewhere on the board
unnamed: R64.2, U12.11 (WE#)
unnamed: R76.2, U12.28 (OE#)
unnamed: R77.2, U12.26 (CE#)
unnamed: U17.6, U17.9
PortAWriteHigh: R67.2, U13.17 (Y1); also elsewhere on the board
PortAWriteLow: R68.2, U13.18 (Y0); also elsewhere on the board
PortBWriteHigh: R65.2, U13.15 (Y3); also elsewhere on the board
PortBWriteLow: R66.2, U13.16 (Y2); also elsewhere on the board
R1Control: R74.2, U14.17 (Y1); also elsewhere on the board
R2Control: R73.2, U14.16 (Y2); also elsewhere on the board
R3Control: R72.2, U14.15 (Y3); also elsewhere on the board
R4Control: R71.2, U14.14 (Y4); also elsewhere on the board
RJBControl: R70.2, U14.13 (Y5); also elsewhere on the board
RMAControl: R69.2, U14.12 (Y6); also elsewhere on the board
RegLatch: U12.43 (DQ14), U17.10, U17.12
StackDown: U12.41 (DQ13); also elsewhere on the board
StackUp: U12.40 (DQ5); also elsewhere on the board
~ALU_Enable: U16.1 (G1), U16.19 (G2); also elsewhere on the board
~CounterOutEnable: U12.35 (DQ3); also elsewhere on the board
~GeneralRegisterLatch: U14.1 (G1), U14.19 (G2), U17.8
~I-O_RegisterLatch: U13.1 (G1), U13.19 (G2), U17.11
~MainRegLeftOutput: U12.29 (DQ0); also elsewhere on the board
~MainRegOutputControl: U12.32 (DQ9); also elsewhere on the board
~MemOutEnable: U12.45 (DQ15); also elsewhere on the board
~MemWriteControl: U12.44 (DQ7); also elsewhere on the board
~PortAReadHigh: R79.2, U15.16 (Y2); also elsewhere on the board
~PortAReadLow: R78.2, U15.15 (Y3); also elsewhere on the board
~PortBReadHigh: R81.2, U15.18 (Y0); also elsewhere on the board
~PortBReadLow: R80.2, U15.17 (Y1); also elsewhere on the board
~PortEnable: U12.30 (DQ8), U15.1 (G1), U15.19 (G2)
~R1Out: R89.2, U16.18 (Y0); also elsewhere on the board
~R2Out: R85.2, U16.14 (Y4); also elsewhere on the board
~R3Out: R88.2, U16.17 (Y1); also elsewhere on the board
~R4Out: R84.2, U16.13 (Y5); also elsewhere on the board
~RJBLeftOutput: R87.2, U16.16 (Y2); also elsewhere on the board
~RJBRightOutput: R83.2, U16.12 (Y6); also elsewhere on the board
~RMALeftOutput: R86.2, U16.15 (Y3); also elsewhere on the board
~RMARightOutput: R82.2, U16.11 (Y7); also elsewhere on the board
~RamAddrEnable: U12.31 (DQ1); also elsewhere on the board
~StackLoad: U12.39 (DQ12); also elsewhere on the board
~StackOut: U12.38 (DQ4); also elsewhere on the board

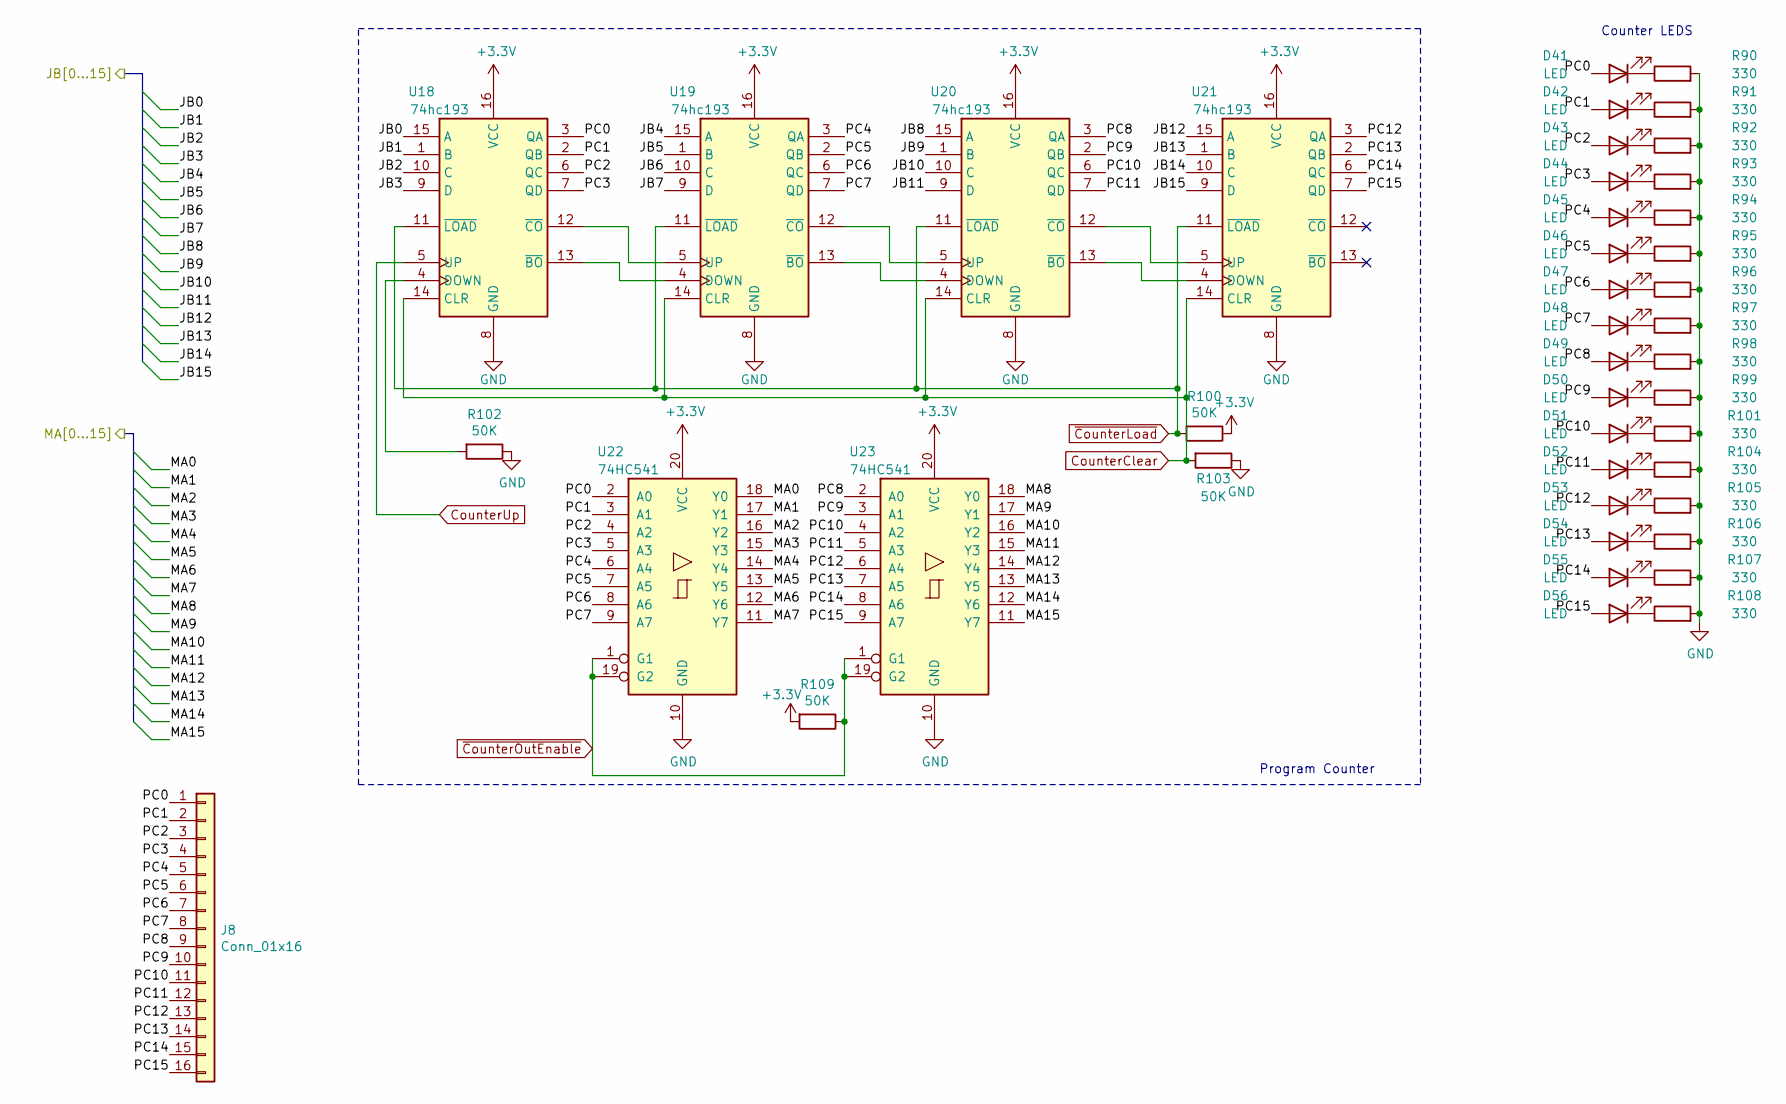
[picture p6: schematic ProgramCounter.sch]

Parts:
D41, D42, D43, D44, D45, D46, D47, D48, D49, D50, D51, D52, D53, D54, D55, D56: LED; LED_0805_2012Metric
J8: Conn_01x16; PinHeader_1x16_P2.54mm_Vertical
R90, R91, R92, R93, R94, R95, R96, R97, R98, R99, R101, R104, R105, R106, R107, R108: 330; R_0805_2012Metric
R100, R102, R103, R109: 50K; R_0805_2012Metric
U18, U19, U20, U21: 74hc193; TSSOP-16_4.4x5mm_P0.65mm
U22, U23: 74HC541; TSSOP-20_4.4x6.5mm_P0.65mm

Connections:
+3V3: R100.1, R109.2, U18.16 (VCC), U19.16 (VCC), U20.16 (VCC), U21.16 (VCC), U22.20 (VCC), U23.20 (VCC); also elsewhere on the board
/Boot Flash/MA0: U22.18 (Y0); also elsewhere on the board
/Boot Flash/MA1: U22.17 (Y1); also elsewhere on the board
/Boot Flash/MA2: U22.16 (Y2); also elsewhere on the board
/Boot Flash/MA3: U22.15 (Y3); also elsewhere on the board
/Boot Flash/MA4: U22.14 (Y4); also elsewhere on the board
/Boot Flash/MA5: U22.13 (Y5); also elsewhere on the board
/Boot Flash/MA6: U22.12 (Y6); also elsewhere on the board
/Boot Flash/MA7: U22.11 (Y7); also elsewhere on the board
/Boot Flash/MA8: U23.18 (Y0); also elsewhere on the board
/Boot Flash/MA9: U23.17 (Y1); also elsewhere on the board
/Boot Flash/MA10: U23.16 (Y2); also elsewhere on the board
/Boot Flash/MA11: U23.15 (Y3); also elsewhere on the board
/Boot Flash/MA12: U23.14 (Y4); also elsewhere on the board
/Boot Flash/MA13: U23.13 (Y5); also elsewhere on the board
/Boot Flash/MA14: U23.12 (Y6); also elsewhere on the board
/Boot Flash/MA15: U23.11 (Y7); also elsewhere on the board
/ProgramCounter/JB0: U18.15 (A); also elsewhere on the board
/ProgramCounter/JB1: U18.1 (B); also elsewhere on the board
/ProgramCounter/JB2: U18.10 (C); also elsewhere on the board
/ProgramCounter/JB3: U18.9 (D); also elsewhere on the board
/ProgramCounter/JB4: U19.15 (A); also elsewhere on the board
/ProgramCounter/JB5: U19.1 (B); also elsewhere on the board
/ProgramCounter/JB6: U19.10 (C); also elsewhere on the board
/ProgramCounter/JB7: U19.9 (D); also elsewhere on the board
/ProgramCounter/JB8: U20.15 (A); also elsewhere on the board
/ProgramCounter/JB9: U20.1 (B); also elsewhere on the board
/ProgramCounter/JB10: U20.10 (C); also elsewhere on the board
/ProgramCounter/JB11: U20.9 (D); also elsewhere on the board
/ProgramCounter/JB12: U21.15 (A); also elsewhere on the board
/ProgramCounter/JB13: U21.1 (B); also elsewhere on the board
/ProgramCounter/JB14: U21.10 (C); also elsewhere on the board
/ProgramCounter/JB15: U21.9 (D); also elsewhere on the board
/ProgramCounter/PC0: D41.2 (A), J8.1, U18.3 (QA), U22.2 (A0)
/ProgramCounter/PC1: D42.2 (A), J8.2, U18.2 (QB), U22.3 (A1)
/ProgramCounter/PC2: D43.2 (A), J8.3, U18.6 (QC), U22.4 (A2)
/ProgramCounter/PC3: D44.2 (A), J8.4, U18.7 (QD), U22.5 (A3)
/ProgramCounter/PC4: D45.2 (A), J8.5, U19.3 (QA), U22.6 (A4)
/ProgramCounter/PC5: D46.2 (A), J8.6, U19.2 (QB), U22.7 (A5)
/ProgramCounter/PC6: D47.2 (A), J8.7, U19.6 (QC), U22.8 (A6)
/ProgramCounter/PC7: D48.2 (A), J8.8, U19.7 (QD), U22.9 (A7)
/ProgramCounter/PC8: D49.2 (A), J8.9, U20.3 (QA), U23.2 (A0)
/ProgramCounter/PC9: D50.2 (A), J8.10, U20.2 (QB), U23.3 (A1)
/ProgramCounter/PC10: D51.2 (A), J8.11, U20.6 (QC), U23.4 (A2)
/ProgramCounter/PC11: D52.2 (A), J8.12, U20.7 (QD), U23.5 (A3)
/ProgramCounter/PC12: D53.2 (A), J8.13, U21.3 (QA), U23.6 (A4)
/ProgramCounter/PC13: D54.2 (A), J8.14, U21.2 (QB), U23.7 (A5)
/ProgramCounter/PC14: D55.2 (A), J8.15, U21.6 (QC), U23.8 (A6)
/ProgramCounter/PC15: D56.2 (A), J8.16, U21.7 (QD), U23.9 (A7)
CounterClear: R103.2, U18.14 (CLR), U19.14 (CLR), U20.14 (CLR), U21.14 (CLR)
CounterUp: U18.5 (UP); also elsewhere on the board
GND: R90.2, R91.2, R92.2, R93.2, R94.2, R95.2, R96.2, R97.2, R98.2, R99.2, R101.2, R102.1, R103.1, R104.2, R105.2, R106.2, R107.2, R108.2, U18.8 (GND), U19.8 (GND), U20.8 (GND), U21.8 (GND), U22.10 (GND), U23.10 (GND); also elsewhere on the board
unnamed: D41.1 (K), R90.1
unnamed: D42.1 (K), R91.1
unnamed: D43.1 (K), R92.1
unnamed: D44.1 (K), R93.1
unnamed: D45.1 (K), R94.1
unnamed: D46.1 (K), R95.1
unnamed: D47.1 (K), R96.1
unnamed: D48.1 (K), R97.1
unnamed: D49.1 (K), R98.1
unnamed: D50.1 (K), R99.1
unnamed: D51.1 (K), R101.1
unnamed: D52.1 (K), R104.1
unnamed: D53.1 (K), R105.1
unnamed: D54.1 (K), R106.1
unnamed: D55.1 (K), R107.1
unnamed: D56.1 (K), R108.1
unnamed: R102.2, U18.4 (DOWN)
unnamed: U18.12 (~CO), U19.5 (UP)
unnamed: U18.13 (~BO), U19.4 (DOWN)
unnamed: U19.12 (~CO), U20.5 (UP)
unnamed: U19.13 (~BO), U20.4 (DOWN)
unnamed: U20.12 (~CO), U21.5 (UP)
unnamed: U20.13 (~BO), U21.4 (DOWN)
~CounterLoad: R100.2, U18.11 (~LOAD), U19.11 (~LOAD), U20.11 (~LOAD), U21.11 (~LOAD); also elsewhere on the board
~CounterOutEnable: R109.1, U22.1 (G1), U22.19 (G2), U23.1 (G1), U23.19 (G2); also elsewhere on the board

Notes on the sheet:
Program Counter
Counter LEDS
