Eviper01/MAX7000CPU-GEN3/S3-Kicad/S3_Schematic.kicad_pcb

## KiCad design S3-Kicad/S3_Schematic.kicad_pcb (continued)

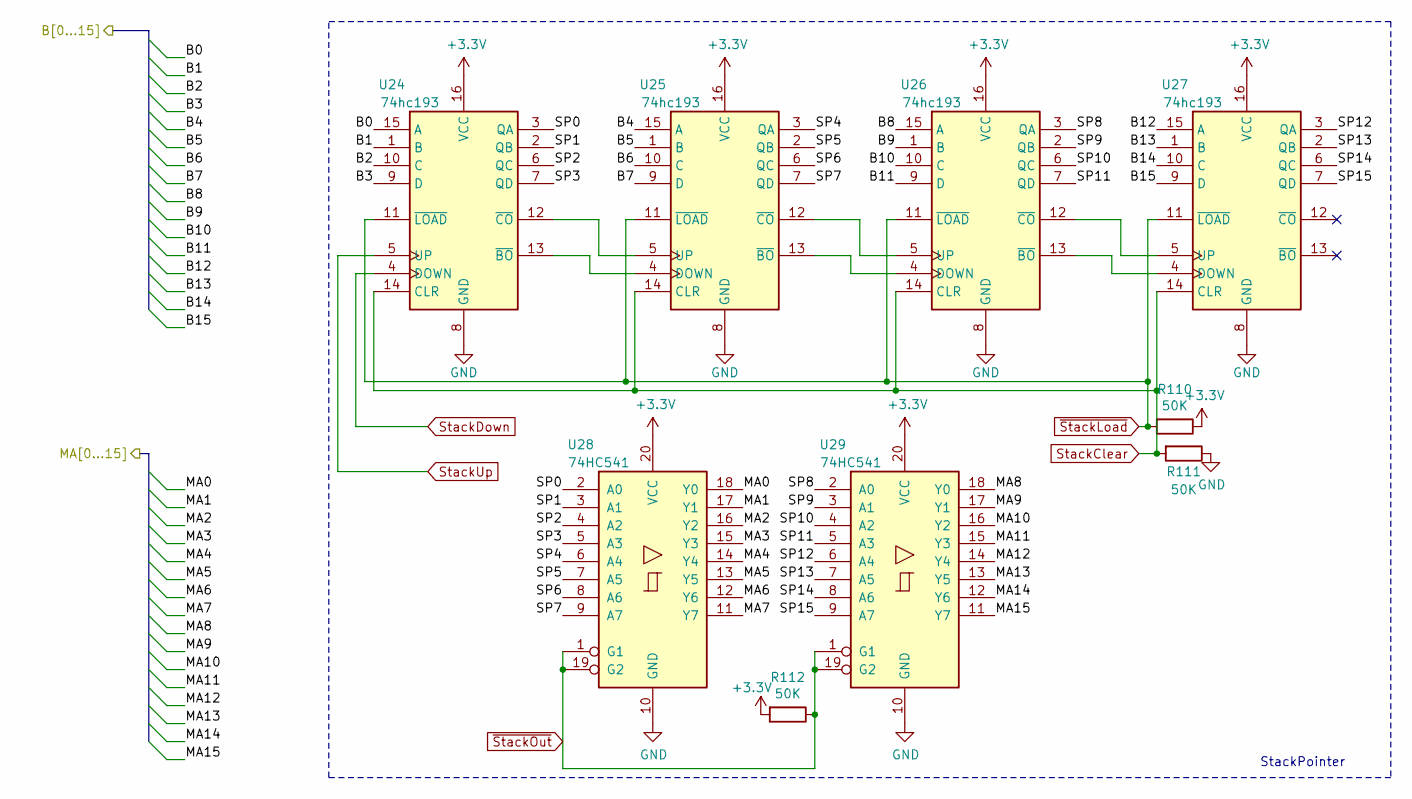
[picture p7: schematic StackPointer.sch]

Parts:
R110, R111, R112: 50K; R_0805_2012Metric
U24, U25, U26, U27: 74hc193; TSSOP-16_4.4x5mm_P0.65mm
U28, U29: 74HC541; TSSOP-20_4.4x6.5mm_P0.65mm

Connections:
+3V3: R110.1, R112.2, U24.16 (VCC), U25.16 (VCC), U26.16 (VCC), U27.16 (VCC), U28.20 (VCC), U29.20 (VCC); also elsewhere on the board
/ALU/B0: U24.15 (A); also elsewhere on the board
/ALU/B1: U24.1 (B); also elsewhere on the board
/ALU/B2: U24.10 (C); also elsewhere on the board
/ALU/B3: U24.9 (D); also elsewhere on the board
/ALU/B4: U25.15 (A); also elsewhere on the board
/ALU/B5: U25.1 (B); also elsewhere on the board
/ALU/B6: U25.10 (C); also elsewhere on the board
/ALU/B7: U25.9 (D); also elsewhere on the board
/ALU/B8: U26.15 (A); also elsewhere on the board
/ALU/B9: U26.1 (B); also elsewhere on the board
/ALU/B10: U26.10 (C); also elsewhere on the board
/ALU/B11: U26.9 (D); also elsewhere on the board
/ALU/B12: U27.15 (A); also elsewhere on the board
/ALU/B13: U27.1 (B); also elsewhere on the board
/ALU/B14: U27.10 (C); also elsewhere on the board
/ALU/B15: U27.9 (D); also elsewhere on the board
/Boot Flash/MA0: U28.18 (Y0); also elsewhere on the board
/Boot Flash/MA1: U28.17 (Y1); also elsewhere on the board
/Boot Flash/MA2: U28.16 (Y2); also elsewhere on the board
/Boot Flash/MA3: U28.15 (Y3); also elsewhere on the board
/Boot Flash/MA4: U28.14 (Y4); also elsewhere on the board
/Boot Flash/MA5: U28.13 (Y5); also elsewhere on the board
/Boot Flash/MA6: U28.12 (Y6); also elsewhere on the board
/Boot Flash/MA7: U28.11 (Y7); also elsewhere on the board
/Boot Flash/MA8: U29.18 (Y0); also elsewhere on the board
/Boot Flash/MA9: U29.17 (Y1); also elsewhere on the board
/Boot Flash/MA10: U29.16 (Y2); also elsewhere on the board
/Boot Flash/MA11: U29.15 (Y3); also elsewhere on the board
/Boot Flash/MA12: U29.14 (Y4); also elsewhere on the board
/Boot Flash/MA13: U29.13 (Y5); also elsewhere on the board
/Boot Flash/MA14: U29.12 (Y6); also elsewhere on the board
/Boot Flash/MA15: U29.11 (Y7); also elsewhere on the board
/StackPointer/SP0: U24.3 (QA), U28.2 (A0)
/StackPointer/SP1: U24.2 (QB), U28.3 (A1)
/StackPointer/SP2: U24.6 (QC), U28.4 (A2)
/StackPointer/SP3: U24.7 (QD), U28.5 (A3)
/StackPointer/SP4: U25.3 (QA), U28.6 (A4)
/StackPointer/SP5: U25.2 (QB), U28.7 (A5)
/StackPointer/SP6: U25.6 (QC), U28.8 (A6)
/StackPointer/SP7: U25.7 (QD), U28.9 (A7)
/StackPointer/SP8: U26.3 (QA), U29.2 (A0)
/StackPointer/SP9: U26.2 (QB), U29.3 (A1)
/StackPointer/SP10: U26.6 (QC), U29.4 (A2)
/StackPointer/SP11: U26.7 (QD), U29.5 (A3)
/StackPointer/SP12: U27.3 (QA), U29.6 (A4)
/StackPointer/SP13: U27.2 (QB), U29.7 (A5)
/StackPointer/SP14: U27.6 (QC), U29.8 (A6)
/StackPointer/SP15: U27.7 (QD), U29.9 (A7)
GND: R111.1, U24.8 (GND), U25.8 (GND), U26.8 (GND), U27.8 (GND), U28.10 (GND), U29.10 (GND); also elsewhere on the board
unnamed: U24.12 (~CO), U25.5 (UP)
unnamed: U24.13 (~BO), U25.4 (DOWN)
unnamed: U25.12 (~CO), U26.5 (UP)
unnamed: U25.13 (~BO), U26.4 (DOWN)
unnamed: U26.12 (~CO), U27.5 (UP)
unnamed: U26.13 (~BO), U27.4 (DOWN)
StackClear: R111.2, U24.14 (CLR), U25.14 (CLR), U26.14 (CLR), U27.14 (CLR)
StackDown: U24.4 (DOWN); also elsewhere on the board
StackUp: U24.5 (UP); also elsewhere on the board
~StackLoad: R110.2, U24.11 (~LOAD), U25.11 (~LOAD), U26.11 (~LOAD), U27.11 (~LOAD); also elsewhere on the board
~StackOut: R112.1, U28.1 (G1), U28.19 (G2), U29.1 (G1), U29.19 (G2); also elsewhere on the board

Notes on the sheet:
StackPointer

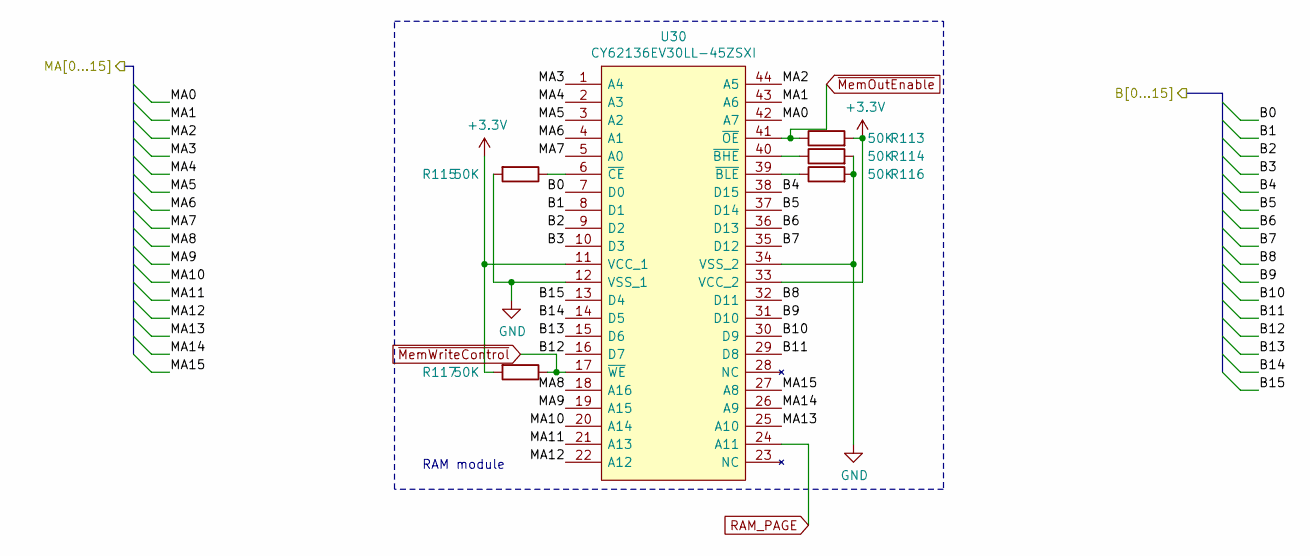
[picture p8: schematic Memory.sch]

Parts:
R113, R114, R115, R116, R117: 50K; R_0805_2012Metric
U30: CY62136EV30LL-45ZSXI; TSOP-II-44_10.16x18.41mm_P0.8mm; Manufacturer_Part_Number CY62136EV30LL-45ZSXI

Connections:
+3V3: R113.2, R117.2, U30.11 (VCC_1), U30.33 (VCC_2); also elsewhere on the board
/ALU/B0: U30.7 (D0); also elsewhere on the board
/ALU/B1: U30.8 (D1); also elsewhere on the board
/ALU/B2: U30.9 (D2); also elsewhere on the board
/ALU/B3: U30.10 (D3); also elsewhere on the board
/ALU/B4: U30.38 (D15); also elsewhere on the board
/ALU/B5: U30.37 (D14); also elsewhere on the board
/ALU/B6: U30.36 (D13); also elsewhere on the board
/ALU/B7: U30.35 (D12); also elsewhere on the board
/ALU/B8: U30.32 (D11); also elsewhere on the board
/ALU/B9: U30.31 (D10); also elsewhere on the board
/ALU/B10: U30.30 (D9); also elsewhere on the board
/ALU/B11: U30.29 (D8); also elsewhere on the board
/ALU/B12: U30.16 (D7); also elsewhere on the board
/ALU/B13: U30.15 (D6); also elsewhere on the board
/ALU/B14: U30.14 (D5); also elsewhere on the board
/ALU/B15: U30.13 (D4); also elsewhere on the board
/Boot Flash/MA0: U30.42 (A7); also elsewhere on the board
/Boot Flash/MA1: U30.43 (A6); also elsewhere on the board
/Boot Flash/MA2: U30.44 (A5); also elsewhere on the board
/Boot Flash/MA3: U30.1 (A4); also elsewhere on the board
/Boot Flash/MA4: U30.2 (A3); also elsewhere on the board
/Boot Flash/MA5: U30.3 (A2); also elsewhere on the board
/Boot Flash/MA6: U30.4 (A1); also elsewhere on the board
/Boot Flash/MA7: U30.5 (A0); also elsewhere on the board
/Boot Flash/MA8: U30.18 (A16); also elsewhere on the board
/Boot Flash/MA9: U30.19 (A15); also elsewhere on the board
/Boot Flash/MA10: U30.20 (A14); also elsewhere on the board
/Boot Flash/MA11: U30.21 (A13); also elsewhere on the board
/Boot Flash/MA12: U30.22 (A12); also elsewhere on the board
/Boot Flash/MA13: U30.25 (A10); also elsewhere on the board
/Boot Flash/MA14: U30.26 (A9); also elsewhere on the board
/Boot Flash/MA15: U30.27 (A8); also elsewhere on the board
GND: R114.2, R115.2, R116.2, U30.12 (VSS_1), U30.34 (VSS_2); also elsewhere on the board
unnamed: R114.1, U30.40 (~BHE)
unnamed: R115.1, U30.6 (~CE)
unnamed: R116.1, U30.39 (~BLE)
RAM_PAGE: U30.24 (A11); also elsewhere on the board
~MemOutEnable: R113.1, U30.41 (~OE); also elsewhere on the board
~MemWriteControl: R117.1, U30.17 (~WE); also elsewhere on the board

Notes on the sheet:
RAM module

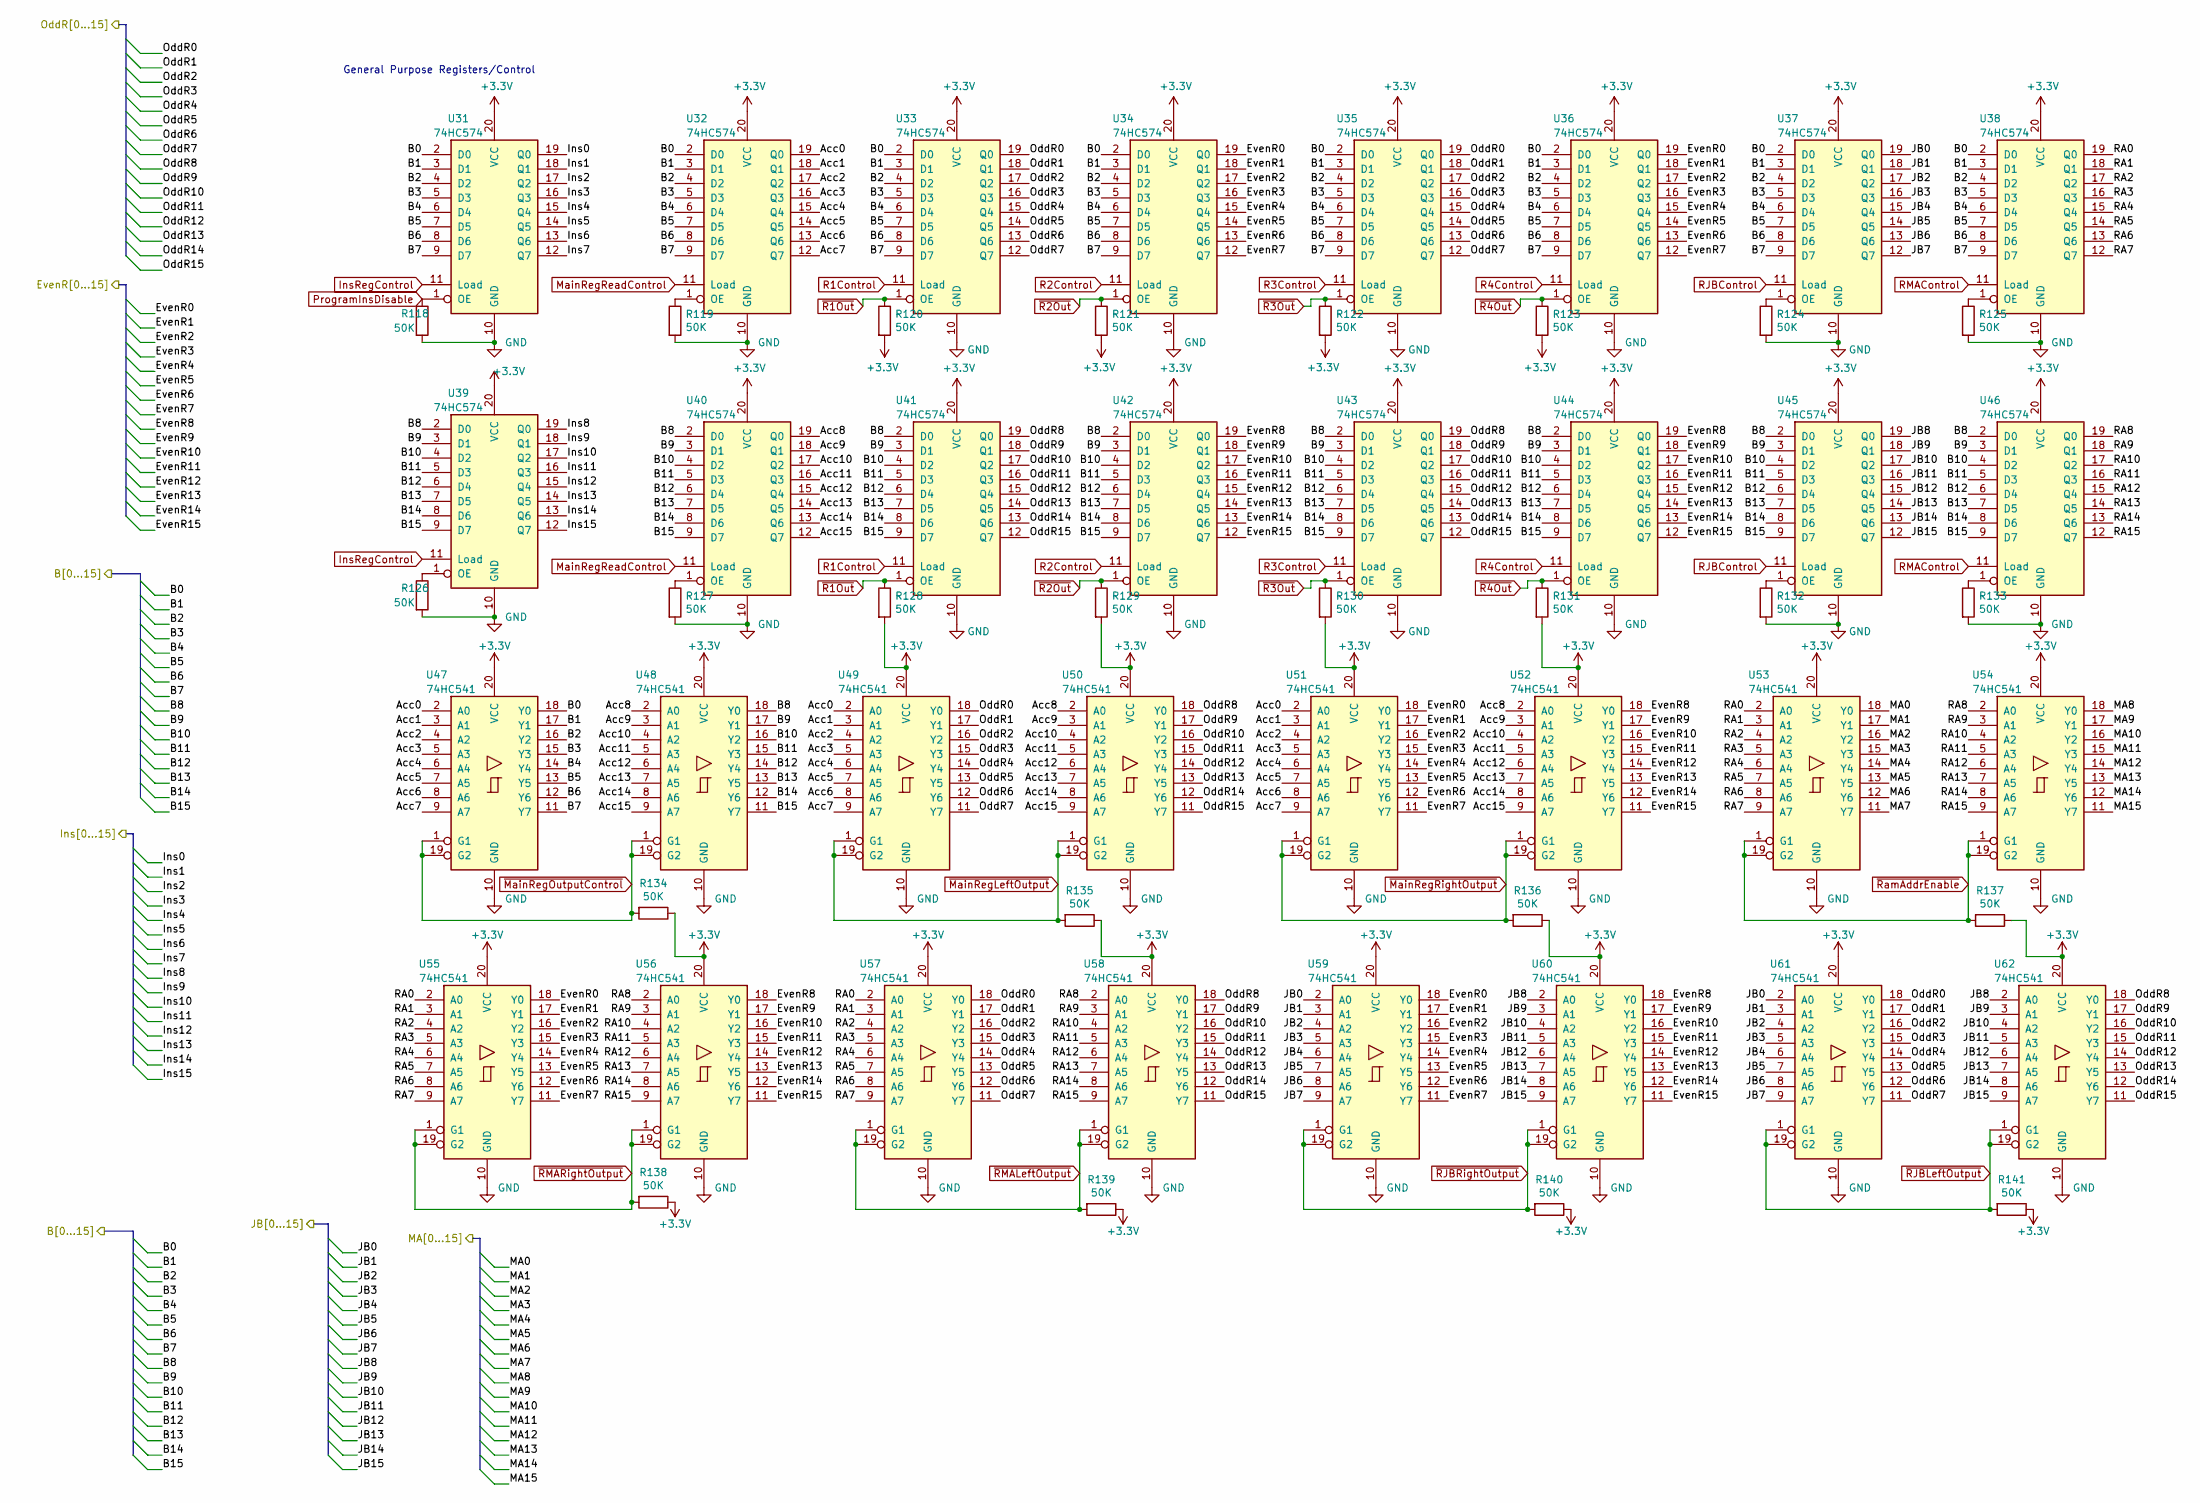
[picture p9: schematic Registers.sch]

Parts:
R118, R119, R120, R121, R122, R123, R124, R125, R126, R127, R128, R129, R130, R131, R132, R133, R134, R135, R136, R137, R138, R139, R140, R141: 50K; R_0805_2012Metric
U31, U32, U33, U34, U35, U36, U37, U38, U39, U40, U41, U42, U43, U44, U45, U46: 74HC574; TSSOP-20_4.4x6.5mm_P0.65mm
U47, U48, U49, U50, U51, U52, U53, U54, U55, U56, U57, U58, U59, U60, U61, U62: 74HC541; TSSOP-20_4.4x6.5mm_P0.65mm

Connections:
+3V3: R120.2, R121.2, R122.2, R123.2, R128.2, R129.2, R130.2, R131.2, R134.1, R135.1, R136.1, R137.1, R138.1, R139.1, R140.1, R141.1, U31.20 (VCC), U32.20 (VCC), U33.20 (VCC), U34.20 (VCC), U35.20 (VCC), U36.20 (VCC), U37.20 (VCC), U38.20 (VCC), U39.20 (VCC), U40.20 (VCC), U41.20 (VCC), U42.20 (VCC), U43.20 (VCC), U44.20 (VCC), U45.20 (VCC), U46.20 (VCC), U47.20 (VCC), U48.20 (VCC), U49.20 (VCC), U50.20 (VCC), U51.20 (VCC), U52.20 (VCC), U53.20 (VCC), U54.20 (VCC), U55.20 (VCC), U56.20 (VCC), U57.20 (VCC), U58.20 (VCC), U59.20 (VCC), U60.20 (VCC), U61.20 (VCC), U62.20 (VCC); also elsewhere on the board
/ALU/B0: U31.2 (D0), U32.2 (D0), U33.2 (D0), U34.2 (D0), U35.2 (D0), U36.2 (D0), U37.2 (D0), U38.2 (D0), U47.18 (Y0); also elsewhere on the board
/ALU/B1: U31.3 (D1), U32.3 (D1), U33.3 (D1), U34.3 (D1), U35.3 (D1), U36.3 (D1), U37.3 (D1), U38.3 (D1), U47.17 (Y1); also elsewhere on the board
/ALU/B2: U31.4 (D2), U32.4 (D2), U33.4 (D2), U34.4 (D2), U35.4 (D2), U36.4 (D2), U37.4 (D2), U38.4 (D2), U47.16 (Y2); also elsewhere on the board
/ALU/B3: U31.5 (D3), U32.5 (D3), U33.5 (D3), U34.5 (D3), U35.5 (D3), U36.5 (D3), U37.5 (D3), U38.5 (D3), U47.15 (Y3); also elsewhere on the board
/ALU/B4: U31.6 (D4), U32.6 (D4), U33.6 (D4), U34.6 (D4), U35.6 (D4), U36.6 (D4), U37.6 (D4), U38.6 (D4), U47.14 (Y4); also elsewhere on the board
/ALU/B5: U31.7 (D5), U32.7 (D5), U33.7 (D5), U34.7 (D5), U35.7 (D5), U36.7 (D5), U37.7 (D5), U38.7 (D5), U47.13 (Y5); also elsewhere on the board
/ALU/B6: U31.8 (D6), U32.8 (D6), U33.8 (D6), U34.8 (D6), U35.8 (D6), U36.8 (D6), U37.8 (D6), U38.8 (D6), U47.12 (Y6); also elsewhere on the board
/ALU/B7: U31.9 (D7), U32.9 (D7), U33.9 (D7), U34.9 (D7), U35.9 (D7), U36.9 (D7), U37.9 (D7), U38.9 (D7), U47.11 (Y7); also elsewhere on the board
/ALU/B8: U39.2 (D0), U40.2 (D0), U41.2 (D0), U42.2 (D0), U43.2 (D0), U44.2 (D0), U45.2 (D0), U46.2 (D0), U48.18 (Y0); also elsewhere on the board
/ALU/B9: U39.3 (D1), U40.3 (D1), U41.3 (D1), U42.3 (D1), U43.3 (D1), U44.3 (D1), U45.3 (D1), U46.3 (D1), U48.17 (Y1); also elsewhere on the board
/ALU/B10: U39.4 (D2), U40.4 (D2), U41.4 (D2), U42.4 (D2), U43.4 (D2), U44.4 (D2), U45.4 (D2), U46.4 (D2), U48.16 (Y2); also elsewhere on the board
/ALU/B11: U39.5 (D3), U40.5 (D3), U41.5 (D3), U42.5 (D3), U43.5 (D3), U44.5 (D3), U45.5 (D3), U46.5 (D3), U48.15 (Y3); also elsewhere on the board
/ALU/B12: U39.6 (D4), U40.6 (D4), U41.6 (D4), U42.6 (D4), U43.6 (D4), U44.6 (D4), U45.6 (D4), U46.6 (D4), U48.14 (Y4); also elsewhere on the board
/ALU/B13: U39.7 (D5), U40.7 (D5), U41.7 (D5), U42.7 (D5), U43.7 (D5), U44.7 (D5), U45.7 (D5), U46.7 (D5), U48.13 (Y5); also elsewhere on the board
/ALU/B14: U39.8 (D6), U40.8 (D6), U41.8 (D6), U42.8 (D6), U43.8 (D6), U44.8 (D6), U45.8 (D6), U46.8 (D6), U48.12 (Y6); also elsewhere on the board
/ALU/B15: U39.9 (D7), U40.9 (D7), U41.9 (D7), U42.9 (D7), U43.9 (D7), U44.9 (D7), U45.9 (D7), U46.9 (D7), U48.11 (Y7); also elsewhere on the board
/ALU/EvenR0: U34.19 (Q0), U36.19 (Q0), U51.18 (Y0), U55.18 (Y0), U59.18 (Y0); also elsewhere on the board
/ALU/EvenR1: U34.18 (Q1), U36.18 (Q1), U51.17 (Y1), U55.17 (Y1), U59.17 (Y1); also elsewhere on the board
/ALU/EvenR2: U34.17 (Q2), U36.17 (Q2), U51.16 (Y2), U55.16 (Y2), U59.16 (Y2); also elsewhere on the board
/ALU/EvenR3: U34.16 (Q3), U36.16 (Q3), U51.15 (Y3), U55.15 (Y3), U59.15 (Y3); also elsewhere on the board
/ALU/EvenR4: U34.15 (Q4), U36.15 (Q4), U51.14 (Y4), U55.14 (Y4), U59.14 (Y4); also elsewhere on the board
/ALU/EvenR5: U34.14 (Q5), U36.14 (Q5), U51.13 (Y5), U55.13 (Y5), U59.13 (Y5); also elsewhere on the board
/ALU/EvenR6: U34.13 (Q6), U36.13 (Q6), U51.12 (Y6), U55.12 (Y6), U59.12 (Y6); also elsewhere on the board
/ALU/EvenR7: U34.12 (Q7), U36.12 (Q7), U51.11 (Y7), U55.11 (Y7), U59.11 (Y7); also elsewhere on the board
/ALU/EvenR8: U42.19 (Q0), U44.19 (Q0), U52.18 (Y0), U56.18 (Y0), U60.18 (Y0); also elsewhere on the board
/ALU/EvenR9: U42.18 (Q1), U44.18 (Q1), U52.17 (Y1), U56.17 (Y1), U60.17 (Y1); also elsewhere on the board
/ALU/EvenR10: U42.17 (Q2), U44.17 (Q2), U52.16 (Y2), U56.16 (Y2), U60.16 (Y2); also elsewhere on the board
/ALU/EvenR11: U42.16 (Q3), U44.16 (Q3), U52.15 (Y3), U56.15 (Y3), U60.15 (Y3); also elsewhere on the board
/ALU/EvenR12: U42.15 (Q4), U44.15 (Q4), U52.14 (Y4), U56.14 (Y4), U60.14 (Y4); also elsewhere on the board
/ALU/EvenR13: U42.14 (Q5), U44.14 (Q5), U52.13 (Y5), U56.13 (Y5), U60.13 (Y5); also elsewhere on the board
/ALU/EvenR14: U42.13 (Q6), U44.13 (Q6), U52.12 (Y6), U56.12 (Y6), U60.12 (Y6); also elsewhere on the board
/ALU/EvenR15: U42.12 (Q7), U44.12 (Q7), U52.11 (Y7), U56.11 (Y7), U60.11 (Y7); also elsewhere on the board
/ALU/Ins0: U31.19 (Q0); also elsewhere on the board
/ALU/Ins1: U31.18 (Q1); also elsewhere on the board
/ALU/Ins2: U31.17 (Q2); also elsewhere on the board
/ALU/Ins3: U31.16 (Q3); also elsewhere on the board
/ALU/Ins4: U31.15 (Q4); also elsewhere on the board
/ALU/Ins5: U31.14 (Q5); also elsewhere on the board
/ALU/Ins6: U31.13 (Q6); also elsewhere on the board
/ALU/Ins7: U31.12 (Q7); also elsewhere on the board
/ALU/Ins8: U39.19 (Q0); also elsewhere on the board
/ALU/Ins9: U39.18 (Q1); also elsewhere on the board
/ALU/Ins10: U39.17 (Q2); also elsewhere on the board
/ALU/Ins11: U39.16 (Q3); also elsewhere on the board
/ALU/Ins12: U39.15 (Q4); also elsewhere on the board
/ALU/Ins13: U39.14 (Q5); also elsewhere on the board
/ALU/Ins14: U39.13 (Q6); also elsewhere on the board
/ALU/Ins15: U39.12 (Q7); also elsewhere on the board
/ALU/OddR0: U33.19 (Q0), U35.19 (Q0), U49.18 (Y0), U57.18 (Y0), U61.18 (Y0); also elsewhere on the board
/ALU/OddR1: U33.18 (Q1), U35.18 (Q1), U49.17 (Y1), U57.17 (Y1), U61.17 (Y1); also elsewhere on the board
/ALU/OddR2: U33.17 (Q2), U35.17 (Q2), U49.16 (Y2), U57.16 (Y2), U61.16 (Y2); also elsewhere on the board
/ALU/OddR3: U33.16 (Q3), U35.16 (Q3), U49.15 (Y3), U57.15 (Y3), U61.15 (Y3); also elsewhere on the board
/ALU/OddR4: U33.15 (Q4), U35.15 (Q4), U49.14 (Y4), U57.14 (Y4), U61.14 (Y4); also elsewhere on the board
/ALU/OddR5: U33.14 (Q5), U35.14 (Q5), U49.13 (Y5), U57.13 (Y5), U61.13 (Y5); also elsewhere on the board
/ALU/OddR6: U33.13 (Q6), U35.13 (Q6), U49.12 (Y6), U57.12 (Y6), U61.12 (Y6); also elsewhere on the board
/ALU/OddR7: U33.12 (Q7), U35.12 (Q7), U49.11 (Y7), U57.11 (Y7), U61.11 (Y7); also elsewhere on the board
/ALU/OddR8: U41.19 (Q0), U43.19 (Q0), U50.18 (Y0), U58.18 (Y0), U62.18 (Y0); also elsewhere on the board
/ALU/OddR9: U41.18 (Q1), U43.18 (Q1), U50.17 (Y1), U58.17 (Y1), U62.17 (Y1); also elsewhere on the board
/ALU/OddR10: U41.17 (Q2), U43.17 (Q2), U50.16 (Y2), U58.16 (Y2), U62.16 (Y2); also elsewhere on the board
/ALU/OddR11: U41.16 (Q3), U43.16 (Q3), U50.15 (Y3), U58.15 (Y3), U62.15 (Y3); also elsewhere on the board
/ALU/OddR12: U41.15 (Q4), U43.15 (Q4), U50.14 (Y4), U58.14 (Y4), U62.14 (Y4); also elsewhere on the board
/ALU/OddR13: U41.14 (Q5), U43.14 (Q5), U50.13 (Y5), U58.13 (Y5), U62.13 (Y5); also elsewhere on the board
/ALU/OddR14: U41.13 (Q6), U43.13 (Q6), U50.12 (Y6), U58.12 (Y6), U62.12 (Y6); also elsewhere on the board
/ALU/OddR15: U41.12 (Q7), U43.12 (Q7), U50.11 (Y7), U58.11 (Y7), U62.11 (Y7); also elsewhere on the board
/Boot Flash/MA0: U53.18 (Y0); also elsewhere on the board
/Boot Flash/MA1: U53.17 (Y1); also elsewhere on the board
/Boot Flash/MA2: U53.16 (Y2); also elsewhere on the board
/Boot Flash/MA3: U53.15 (Y3); also elsewhere on the board
/Boot Flash/MA4: U53.14 (Y4); also elsewhere on the board
/Boot Flash/MA5: U53.13 (Y5); also elsewhere on the board
/Boot Flash/MA6: U53.12 (Y6); also elsewhere on the board
/Boot Flash/MA7: U53.11 (Y7); also elsewhere on the board
/Boot Flash/MA8: U54.18 (Y0); also elsewhere on the board
/Boot Flash/MA9: U54.17 (Y1); also elsewhere on the board
/Boot Flash/MA10: U54.16 (Y2); also elsewhere on the board
/Boot Flash/MA11: U54.15 (Y3); also elsewhere on the board
/Boot Flash/MA12: U54.14 (Y4); also elsewhere on the board
/Boot Flash/MA13: U54.13 (Y5); also elsewhere on the board
/Boot Flash/MA14: U54.12 (Y6); also elsewhere on the board
/Boot Flash/MA15: U54.11 (Y7); also elsewhere on the board
/ProgramCounter/JB0: U37.19 (Q0), U59.2 (A0), U61.2 (A0); also elsewhere on the board
/ProgramCounter/JB1: U37.18 (Q1), U59.3 (A1), U61.3 (A1); also elsewhere on the board
/ProgramCounter/JB2: U37.17 (Q2), U59.4 (A2), U61.4 (A2); also elsewhere on the board
/ProgramCounter/JB3: U37.16 (Q3), U59.5 (A3), U61.5 (A3); also elsewhere on the board
/ProgramCounter/JB4: U37.15 (Q4), U59.6 (A4), U61.6 (A4); also elsewhere on the board
/ProgramCounter/JB5: U37.14 (Q5), U59.7 (A5), U61.7 (A5); also elsewhere on the board
/ProgramCounter/JB6: U37.13 (Q6), U59.8 (A6), U61.8 (A6); also elsewhere on the board
/ProgramCounter/JB7: U37.12 (Q7), U59.9 (A7), U61.9 (A7); also elsewhere on the board
/ProgramCounter/JB8: U45.19 (Q0), U60.2 (A0), U62.2 (A0); also elsewhere on the board
/ProgramCounter/JB9: U45.18 (Q1), U60.3 (A1), U62.3 (A1); also elsewhere on the board
/ProgramCounter/JB10: U45.17 (Q2), U60.4 (A2), U62.4 (A2); also elsewhere on the board
/ProgramCounter/JB11: U45.16 (Q3), U60.5 (A3), U62.5 (A3); also elsewhere on the board
/ProgramCounter/JB12: U45.15 (Q4), U60.6 (A4), U62.6 (A4); also elsewhere on the board
/ProgramCounter/JB13: U45.14 (Q5), U60.7 (A5), U62.7 (A5); also elsewhere on the board
/ProgramCounter/JB14: U45.13 (Q6), U60.8 (A6), U62.8 (A6); also elsewhere on the board
/ProgramCounter/JB15: U45.12 (Q7), U60.9 (A7), U62.9 (A7); also elsewhere on the board
/Registers/Acc0: U32.19 (Q0), U47.2 (A0), U49.2 (A0), U51.2 (A0)
/Registers/Acc1: U32.18 (Q1), U47.3 (A1), U49.3 (A1), U51.3 (A1)
/Registers/Acc2: U32.17 (Q2), U47.4 (A2), U49.4 (A2), U51.4 (A2)
/Registers/Acc3: U32.16 (Q3), U47.5 (A3), U49.5 (A3), U51.5 (A3)
/Registers/Acc4: U32.15 (Q4), U47.6 (A4), U49.6 (A4), U51.6 (A4)
/Registers/Acc5: U32.14 (Q5), U47.7 (A5), U49.7 (A5), U51.7 (A5)
/Registers/Acc6: U32.13 (Q6), U47.8 (A6), U49.8 (A6), U51.8 (A6)
/Registers/Acc7: U32.12 (Q7), U47.9 (A7), U49.9 (A7), U51.9 (A7)
/Registers/Acc8: U40.19 (Q0), U48.2 (A0), U50.2 (A0), U52.2 (A0)
/Registers/Acc9: U40.18 (Q1), U48.3 (A1), U50.3 (A1), U52.3 (A1)
/Registers/Acc10: U40.17 (Q2), U48.4 (A2), U50.4 (A2), U52.4 (A2)
/Registers/Acc11: U40.16 (Q3), U48.5 (A3), U50.5 (A3), U52.5 (A3)
/Registers/Acc12: U40.15 (Q4), U48.6 (A4), U50.6 (A4), U52.6 (A4)
/Registers/Acc13: U40.14 (Q5), U48.7 (A5), U50.7 (A5), U52.7 (A5)
/Registers/Acc14: U40.13 (Q6), U48.8 (A6), U50.8 (A6), U52.8 (A6)
/Registers/Acc15: U40.12 (Q7), U48.9 (A7), U50.9 (A7), U52.9 (A7)
/Registers/RA0: U38.19 (Q0), U53.2 (A0), U55.2 (A0), U57.2 (A0)
/Registers/RA1: U38.18 (Q1), U53.3 (A1), U55.3 (A1), U57.3 (A1)
/Registers/RA2: U38.17 (Q2), U53.4 (A2), U55.4 (A2), U57.4 (A2)
/Registers/RA3: U38.16 (Q3), U53.5 (A3), U55.5 (A3), U57.5 (A3)
/Registers/RA4: U38.15 (Q4), U53.6 (A4), U55.6 (A4), U57.6 (A4)
/Registers/RA5: U38.14 (Q5), U53.7 (A5), U55.7 (A5), U57.7 (A5)
/Registers/RA6: U38.13 (Q6), U53.8 (A6), U55.8 (A6), U57.8 (A6)
/Registers/RA7: U38.12 (Q7), U53.9 (A7), U55.9 (A7), U57.9 (A7)
/Registers/RA8: U46.19 (Q0), U54.2 (A0), U56.2 (A0), U58.2 (A0)
/Registers/RA9: U46.18 (Q1), U54.3 (A1), U56.3 (A1), U58.3 (A1)
/Registers/RA10: U46.17 (Q2), U54.4 (A2), U56.4 (A2), U58.4 (A2)
/Registers/RA11: U46.16 (Q3), U54.5 (A3), U56.5 (A3), U58.5 (A3)
/Registers/RA12: U46.15 (Q4), U54.6 (A4), U56.6 (A4), U58.6 (A4)
/Registers/RA13: U46.14 (Q5), U54.7 (A5), U56.7 (A5), U58.7 (A5)
/Registers/RA14: U46.13 (Q6), U54.8 (A6), U56.8 (A6), U58.8 (A6)
/Registers/RA15: U46.12 (Q7), U54.9 (A7), U56.9 (A7), U58.9 (A7)
GND: R118.2, R119.2, R124.2, R125.2, R126.2, R127.2, R132.2, R133.2, U31.10 (GND), U32.10 (GND), U33.10 (GND), U34.10 (GND), U35.10 (GND), U36.10 (GND), U37.10 (GND), U38.10 (GND), U39.10 (GND), U40.10 (GND), U41.10 (GND), U42.10 (GND), U43.10 (GND), U44.10 (GND), U45.10 (GND), U46.10 (GND), U47.10 (GND), U48.10 (GND), U49.10 (GND), U50.10 (GND), U51.10 (GND), U52.10 (GND), U53.10 (GND), U54.10 (GND), U55.10 (GND), U56.10 (GND), U57.10 (GND), U58.10 (GND), U59.10 (GND), U60.10 (GND), U61.10 (GND), U62.10 (GND); also elsewhere on the board
InsRegControl: U31.11 (Load), U39.11 (Load); also elsewhere on the board
MainRegReadControl: U32.11 (Load), U40.11 (Load); also elsewhere on the board
unnamed: R119.1, U32.1 (OE)
unnamed: R124.1, U37.1 (OE)
unnamed: R125.1, U38.1 (OE)
unnamed: R126.1, U39.1 (OE)
unnamed: R127.1, U40.1 (OE)
unnamed: R132.1, U45.1 (OE)
unnamed: R133.1, U46.1 (OE)
ProgramInsDisable: R118.1, U31.1 (OE); also elsewhere on the board
R1Control: U33.11 (Load), U41.11 (Load); also elsewhere on the board
R2Control: U34.11 (Load), U42.11 (Load); also elsewhere on the board
R3Control: U35.11 (Load), U43.11 (Load); also elsewhere on the board
R4Control: U36.11 (Load), U44.11 (Load); also elsewhere on the board
RJBControl: U37.11 (Load), U45.11 (Load); also elsewhere on the board
RMAControl: U38.11 (Load), U46.11 (Load); also elsewhere on the board
~MainRegLeftOutput: R135.2, U49.1 (G1), U49.19 (G2), U50.1 (G1), U50.19 (G2); also elsewhere on the board
~MainRegOutputControl: R134.2, U47.1 (G1), U47.19 (G2), U48.1 (G1), U48.19 (G2); also elsewhere on the board
~MainRegRightOutput: R136.2, U51.1 (G1), U51.19 (G2), U52.1 (G1), U52.19 (G2); also elsewhere on the board
~R1Out: R120.1, R128.1, U33.1 (OE), U41.1 (OE); also elsewhere on the board
~R2Out: R121.1, R129.1, U34.1 (OE), U42.1 (OE); also elsewhere on the board
~R3Out: R122.1, R130.1, U35.1 (OE), U43.1 (OE); also elsewhere on the board
~R4Out: R123.1, R131.1, U36.1 (OE), U44.1 (OE); also elsewhere on the board
~RJBLeftOutput: R141.2, U61.1 (G1), U61.19 (G2), U62.1 (G1), U62.19 (G2); also elsewhere on the board
~RJBRightOutput: R140.2, U59.1 (G1), U59.19 (G2), U60.1 (G1), U60.19 (G2); also elsewhere on the board
~RMALeftOutput: R139.2, U57.1 (G1), U57.19 (G2), U58.1 (G1), U58.19 (G2); also elsewhere on the board
~RMARightOutput: R138.2, U55.1 (G1), U55.19 (G2), U56.1 (G1), U56.19 (G2); also elsewhere on the board
~RamAddrEnable: R137.2, U53.1 (G1), U53.19 (G2), U54.1 (G1), U54.19 (G2); also elsewhere on the board

Notes on the sheet:
General Purpose Registers/Control
