Eviper01/MAX7000CPU-GEN3/S3-Kicad/S3_Schematic.kicad_pcb

## KiCad design S3-Kicad/S3_Schematic.kicad_pcb (continued)

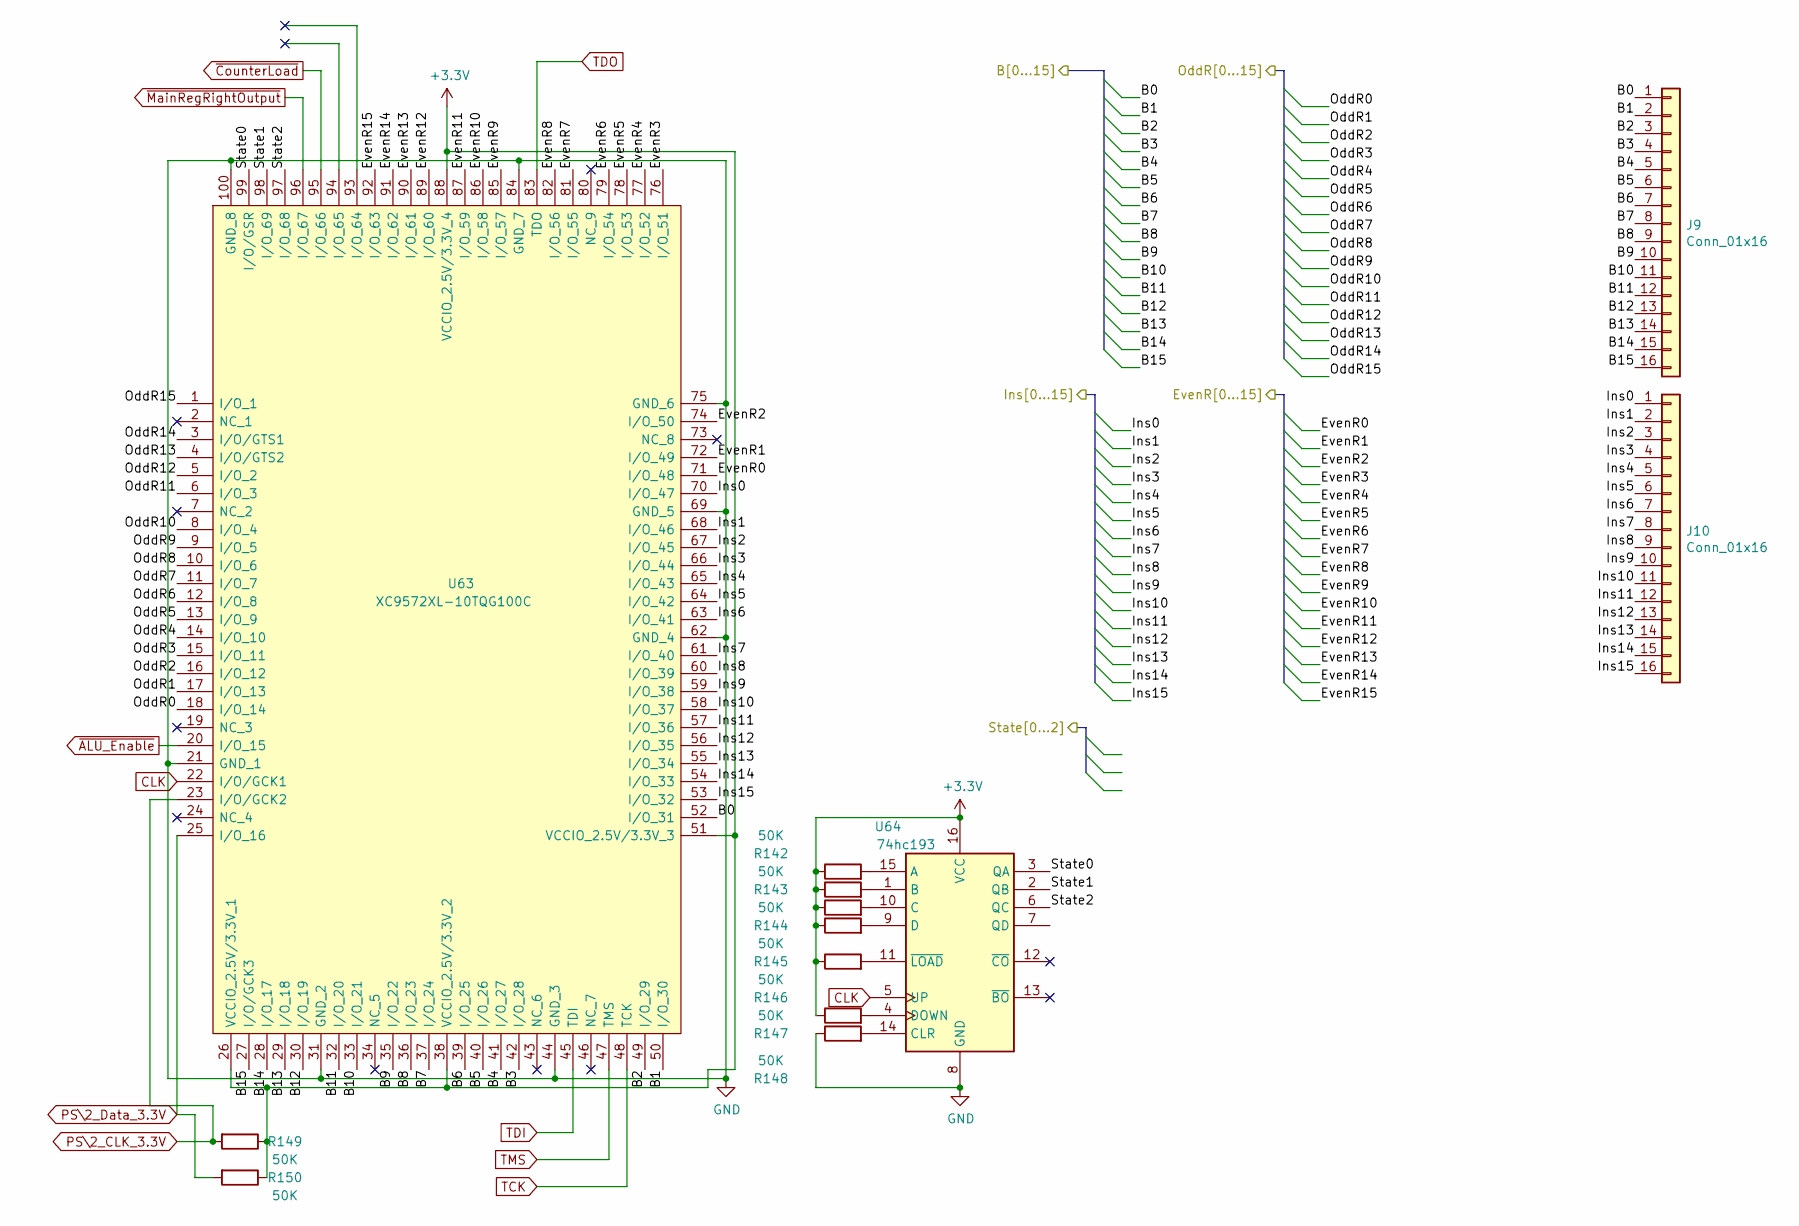
[picture p10: schematic ALU.sch]

Parts:
J9, J10: Conn_01x16; PinHeader_1x16_P2.54mm_Vertical
R142, R143, R144, R145, R146, R147, R148, R149, R150: 50K; R_0805_2012Metric
U63: XC9572XL-10TQG100C; TQFP-100_14x14mm_P0.5mm; Mouser Part Number 217-9572XL-10TQG100C
U64: 74hc193; TSSOP-16_4.4x5mm_P0.65mm

Connections:
+3V3: R142.1, R143.1, R144.1, R145.1, R146.1, R147.1, R149.1, R150.1, U63.26 (VCCIO_2.5V/3.3V_1), U63.38 (VCCIO_2.5V/3.3V_2), U63.51 (VCCIO_2.5V/3.3V_3), U63.88 (VCCIO_2.5V/3.3V_4), U64.16 (VCC); also elsewhere on the board
/ALU/B0: J9.1, U63.52 (I/O_31); also elsewhere on the board
/ALU/B1: J9.2, U63.50 (I/O_30); also elsewhere on the board
/ALU/B2: J9.3, U63.49 (I/O_29); also elsewhere on the board
/ALU/B3: J9.4, U63.42 (I/O_28); also elsewhere on the board
/ALU/B4: J9.5, U63.41 (I/O_27); also elsewhere on the board
/ALU/B5: J9.6, U63.40 (I/O_26); also elsewhere on the board
/ALU/B6: J9.7, U63.39 (I/O_25); also elsewhere on the board
/ALU/B7: J9.8, U63.37 (I/O_24); also elsewhere on the board
/ALU/B8: J9.9, U63.36 (I/O_23); also elsewhere on the board
/ALU/B9: J9.10, U63.35 (I/O_22); also elsewhere on the board
/ALU/B10: J9.11, U63.33 (I/O_21); also elsewhere on the board
/ALU/B11: J9.12, U63.32 (I/O_20); also elsewhere on the board
/ALU/B12: J9.13, U63.30 (I/O_19); also elsewhere on the board
/ALU/B13: J9.14, U63.29 (I/O_18); also elsewhere on the board
/ALU/B14: J9.15, U63.28 (I/O_17); also elsewhere on the board
/ALU/B15: J9.16, U63.27 (I/O/GCK3); also elsewhere on the board
/ALU/EvenR0: U63.71 (I/O_48); also elsewhere on the board
/ALU/EvenR1: U63.72 (I/O_49); also elsewhere on the board
/ALU/EvenR2: U63.74 (I/O_50); also elsewhere on the board
/ALU/EvenR3: U63.76 (I/O_51); also elsewhere on the board
/ALU/EvenR4: U63.77 (I/O_52); also elsewhere on the board
/ALU/EvenR5: U63.78 (I/O_53); also elsewhere on the board
/ALU/EvenR6: U63.79 (I/O_54); also elsewhere on the board
/ALU/EvenR7: U63.81 (I/O_55); also elsewhere on the board
/ALU/EvenR8: U63.82 (I/O_56); also elsewhere on the board
/ALU/EvenR9: U63.85 (I/O_57); also elsewhere on the board
/ALU/EvenR10: U63.86 (I/O_58); also elsewhere on the board
/ALU/EvenR11: U63.87 (I/O_59); also elsewhere on the board
/ALU/EvenR12: U63.89 (I/O_60); also elsewhere on the board
/ALU/EvenR13: U63.90 (I/O_61); also elsewhere on the board
/ALU/EvenR14: U63.91 (I/O_62); also elsewhere on the board
/ALU/EvenR15: U63.92 (I/O_63); also elsewhere on the board
/ALU/Ins0: J10.1, U63.70 (I/O_47); also elsewhere on the board
/ALU/Ins1: J10.2, U63.68 (I/O_46); also elsewhere on the board
/ALU/Ins2: J10.3, U63.67 (I/O_45); also elsewhere on the board
/ALU/Ins3: J10.4, U63.66 (I/O_44); also elsewhere on the board
/ALU/Ins4: J10.5, U63.65 (I/O_43); also elsewhere on the board
/ALU/Ins5: J10.6, U63.64 (I/O_42); also elsewhere on the board
/ALU/Ins6: J10.7, U63.63 (I/O_41); also elsewhere on the board
/ALU/Ins7: J10.8, U63.61 (I/O_40); also elsewhere on the board
/ALU/Ins8: J10.9, U63.60 (I/O_39); also elsewhere on the board
/ALU/Ins9: J10.10, U63.59 (I/O_38); also elsewhere on the board
/ALU/Ins10: J10.11, U63.58 (I/O_37); also elsewhere on the board
/ALU/Ins11: J10.12, U63.57 (I/O_36); also elsewhere on the board
/ALU/Ins12: J10.13, U63.56 (I/O_35); also elsewhere on the board
/ALU/Ins13: J10.14, U63.55 (I/O_34); also elsewhere on the board
/ALU/Ins14: J10.15, U63.54 (I/O_33); also elsewhere on the board
/ALU/Ins15: J10.16, U63.53 (I/O_32); also elsewhere on the board
/ALU/OddR0: U63.18 (I/O_14); also elsewhere on the board
/ALU/OddR1: U63.17 (I/O_13); also elsewhere on the board
/ALU/OddR2: U63.16 (I/O_12); also elsewhere on the board
/ALU/OddR3: U63.15 (I/O_11); also elsewhere on the board
/ALU/OddR4: U63.14 (I/O_10); also elsewhere on the board
/ALU/OddR5: U63.13 (I/O_9); also elsewhere on the board
/ALU/OddR6: U63.12 (I/O_8); also elsewhere on the board
/ALU/OddR7: U63.11 (I/O_7); also elsewhere on the board
/ALU/OddR8: U63.10 (I/O_6); also elsewhere on the board
/ALU/OddR9: U63.9 (I/O_5); also elsewhere on the board
/ALU/OddR10: U63.8 (I/O_4); also elsewhere on the board
/ALU/OddR11: U63.6 (I/O_3); also elsewhere on the board
/ALU/OddR12: U63.5 (I/O_2); also elsewhere on the board
/ALU/OddR13: U63.4 (I/O/GTS2); also elsewhere on the board
/ALU/OddR14: U63.3 (I/O/GTS1); also elsewhere on the board
/ALU/OddR15: U63.1 (I/O_1); also elsewhere on the board
/ALU/State0: U63.99 (I/O/GSR), U64.3 (QA); also elsewhere on the board
/ALU/State1: U63.98 (I/O_69), U64.2 (QB); also elsewhere on the board
/ALU/State2: U63.97 (I/O_68), U64.6 (QC); also elsewhere on the board
CLK: U63.22 (I/O/GCK1), U64.5 (UP); also elsewhere on the board
GND: R148.1, U63.21 (GND_1), U63.31 (GND_2), U63.44 (GND_3), U63.62 (GND_4), U63.69 (GND_5), U63.75 (GND_6), U63.84 (GND_7), U63.100 (GND_8), U64.8 (GND); also elsewhere on the board
unnamed: R142.2, U64.15 (A)
unnamed: R143.2, U64.1 (B)
unnamed: R144.2, U64.10 (C)
unnamed: R145.2, U64.9 (D)
unnamed: R146.2, U64.11 (~LOAD)
unnamed: R147.2, U64.4 (DOWN)
unnamed: R148.2, U64.14 (CLR)
PS\2_CLK_3.3V: R149.2, U63.23 (I/O/GCK2); also elsewhere on the board
PS\2_Data_3.3V: R150.2, U63.25 (I/O_16); also elsewhere on the board
TCK: U63.48 (TCK); also elsewhere on the board
TDI: U63.45 (TDI); also elsewhere on the board
TDO: U63.83 (TDO); also elsewhere on the board
TMS: U63.47 (TMS); also elsewhere on the board
~ALU_Enable: U63.20 (I/O_15); also elsewhere on the board
~CounterLoad: U63.95 (I/O_66); also elsewhere on the board
~MainRegRightOutput: U63.96 (I/O_67); also elsewhere on the board

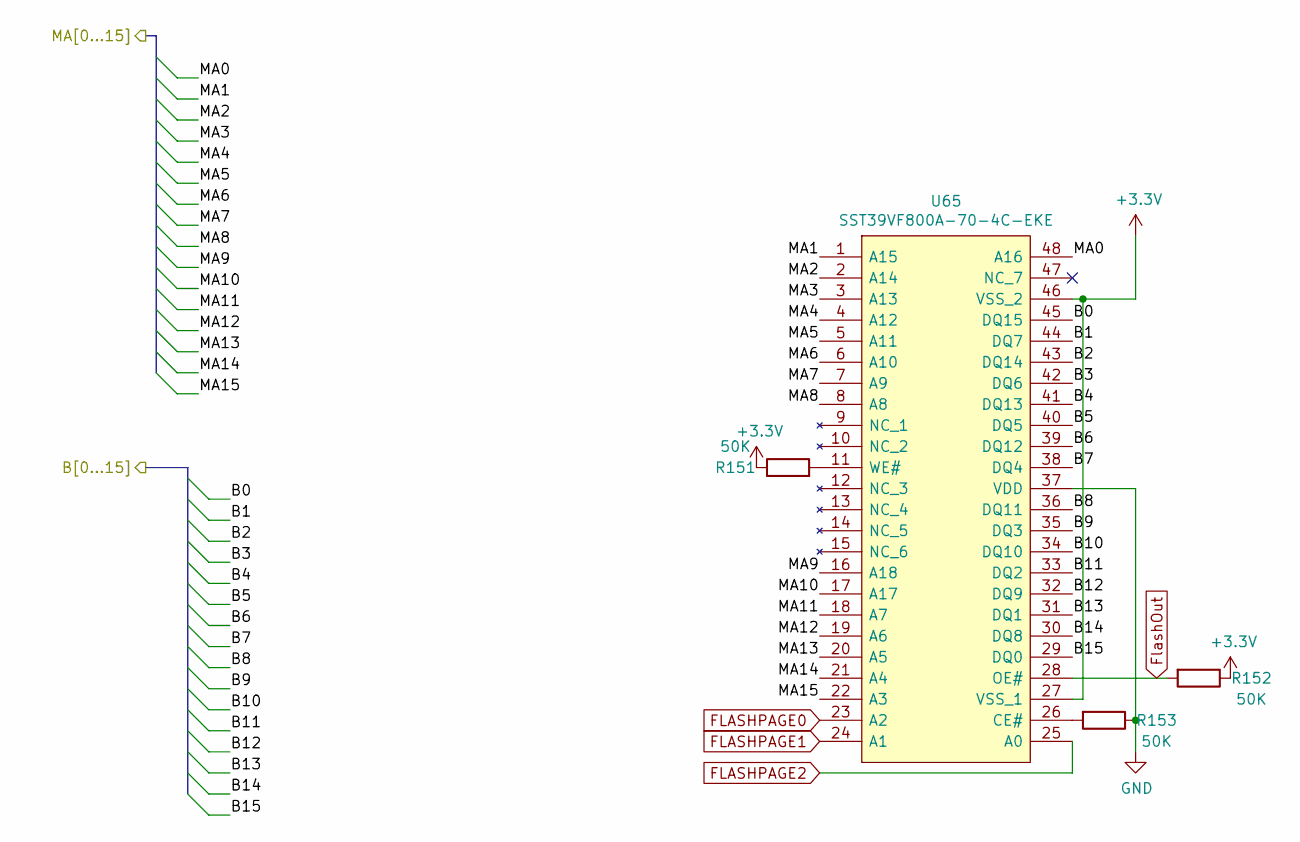
[picture p11: schematic BootFlash.sch]

Parts:
R151, R152, R153: 50K; R_0805_2012Metric
U65: SST39VF800A-70-4C-EKE; TSOP-I-48_18.4x12mm_P0.5mm; Mouser Part Number 804-39VF800A7CEKE

Connections:
+3V3: R151.1, R152.1, U65.27 (VSS_1), U65.46 (VSS_2); also elsewhere on the board
/ALU/B0: U65.45 (DQ15); also elsewhere on the board
/ALU/B1: U65.44 (DQ7); also elsewhere on the board
/ALU/B2: U65.43 (DQ14); also elsewhere on the board
/ALU/B3: U65.42 (DQ6); also elsewhere on the board
/ALU/B4: U65.41 (DQ13); also elsewhere on the board
/ALU/B5: U65.40 (DQ5); also elsewhere on the board
/ALU/B6: U65.39 (DQ12); also elsewhere on the board
/ALU/B7: U65.38 (DQ4); also elsewhere on the board
/ALU/B8: U65.36 (DQ11); also elsewhere on the board
/ALU/B9: U65.35 (DQ3); also elsewhere on the board
/ALU/B10: U65.34 (DQ10); also elsewhere on the board
/ALU/B11: U65.33 (DQ2); also elsewhere on the board
/ALU/B12: U65.32 (DQ9); also elsewhere on the board
/ALU/B13: U65.31 (DQ1); also elsewhere on the board
/ALU/B14: U65.30 (DQ8); also elsewhere on the board
/ALU/B15: U65.29 (DQ0); also elsewhere on the board
/Boot Flash/MA0: U65.48 (A16); also elsewhere on the board
/Boot Flash/MA1: U65.1 (A15); also elsewhere on the board
/Boot Flash/MA2: U65.2 (A14); also elsewhere on the board
/Boot Flash/MA3: U65.3 (A13); also elsewhere on the board
/Boot Flash/MA4: U65.4 (A12); also elsewhere on the board
/Boot Flash/MA5: U65.5 (A11); also elsewhere on the board
/Boot Flash/MA6: U65.6 (A10); also elsewhere on the board
/Boot Flash/MA7: U65.7 (A9); also elsewhere on the board
/Boot Flash/MA8: U65.8 (A8); also elsewhere on the board
/Boot Flash/MA9: U65.16 (A18); also elsewhere on the board
/Boot Flash/MA10: U65.17 (A17); also elsewhere on the board
/Boot Flash/MA11: U65.18 (A7); also elsewhere on the board
/Boot Flash/MA12: U65.19 (A6); also elsewhere on the board
/Boot Flash/MA13: U65.20 (A5); also elsewhere on the board
/Boot Flash/MA14: U65.21 (A4); also elsewhere on the board
/Boot Flash/MA15: U65.22 (A3); also elsewhere on the board
FLASHPAGE0: U65.23 (A2); also elsewhere on the board
FLASHPAGE1: U65.24 (A1); also elsewhere on the board
FLASHPAGE2: U65.25 (A0); also elsewhere on the board
FlashOut: R152.2, U65.28 (OE#); also elsewhere on the board
GND: R153.1, U65.37 (VDD); also elsewhere on the board
unnamed: R151.2, U65.11 (WE#)
unnamed: R153.2, U65.26 (CE#)

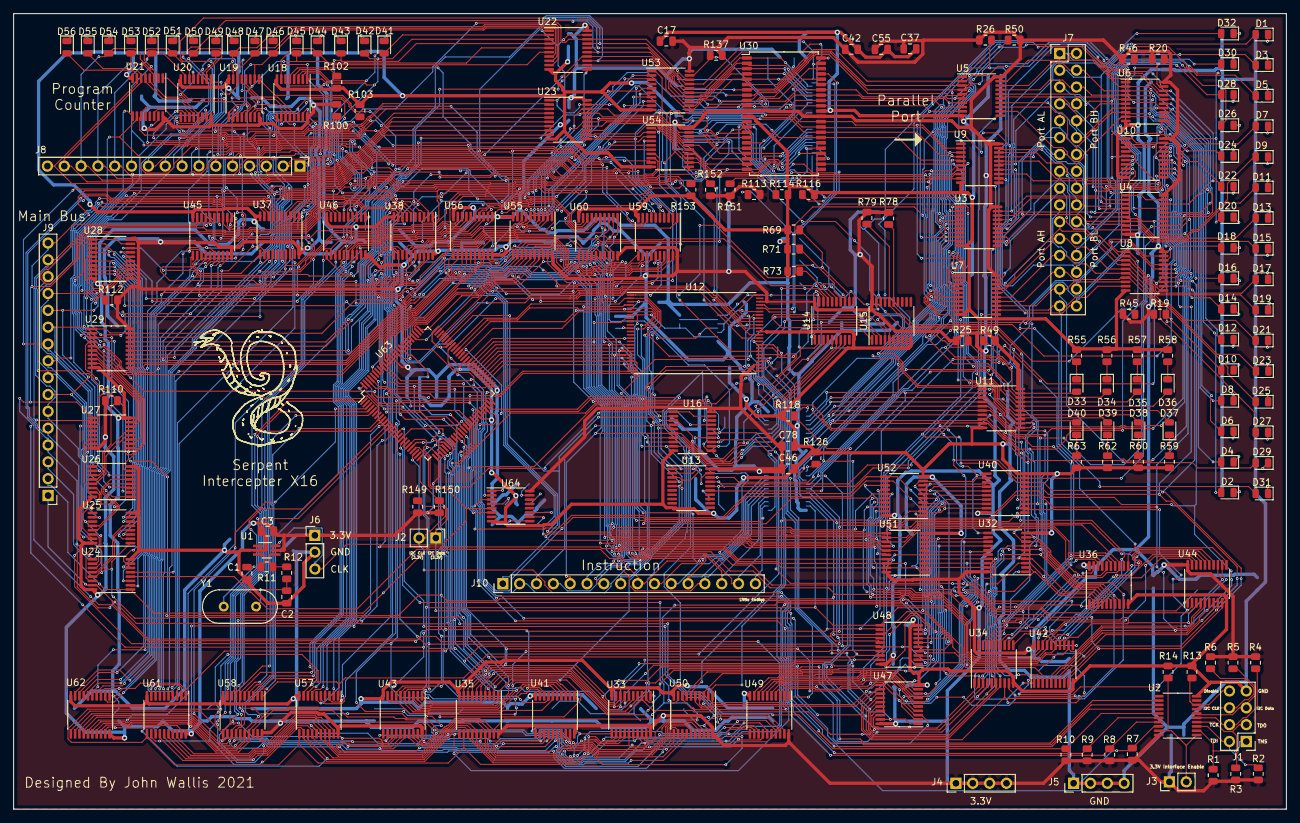
[picture p12: board S3_Schematic.kicad_pcb from above]

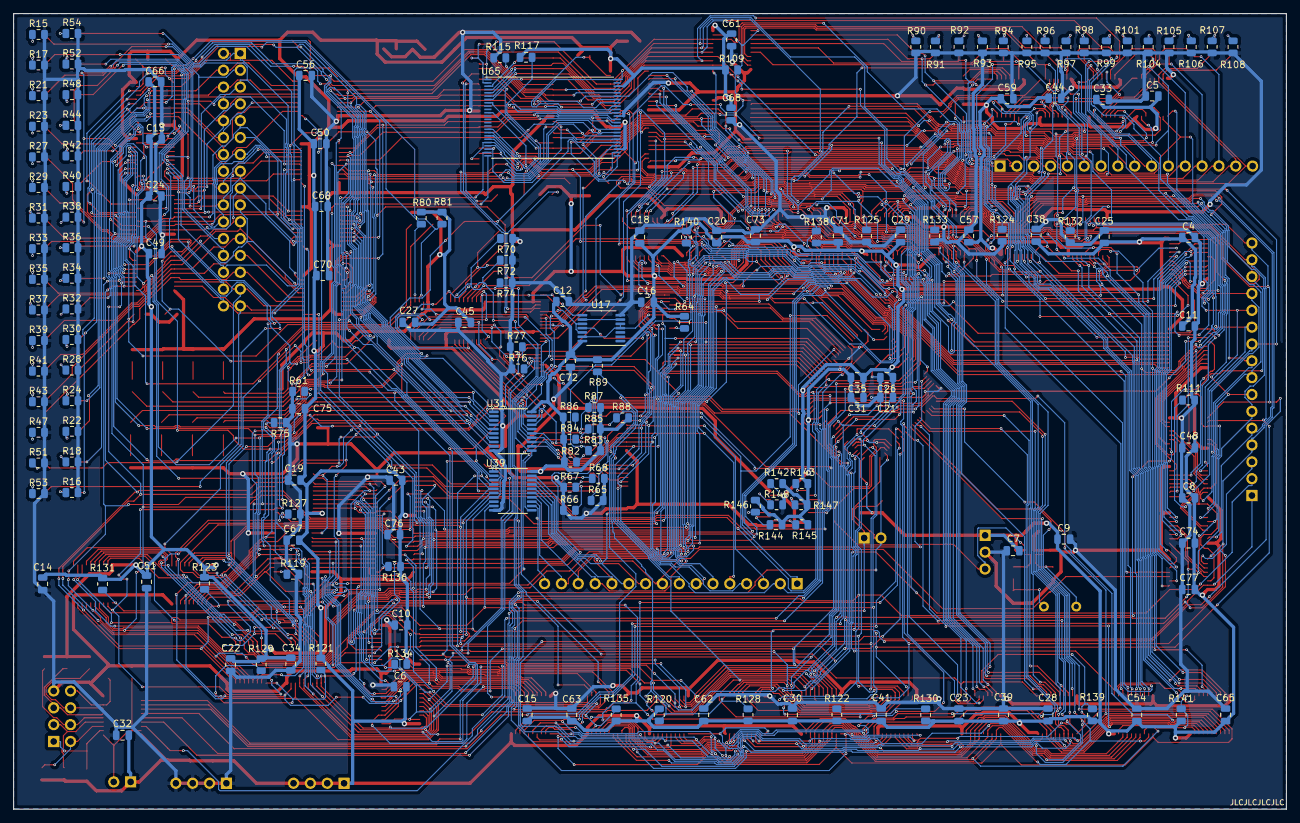
[picture p13: board S3_Schematic.kicad_pcb from below]

Board: 2 copper layers, 192.0 x 120.0 mm, 355 parts (167 on the bottom side), 363 nets.
