Eviper01/MAX7000CPU-GEN3/(commit log)

2021-10-11 registers bank
    [AL_Controller.sch, S3-Kicad.kicad_pcb, S3_Schematic.sch]
2021-10-15 3.3V parts
    [Digikey 3.3v parts.xlsx]
2021-10-22 Most of CPU planned out
    [Digikey 3.3v parts.xlsx, S3_Schematic.sch]
2021-10-24 some weekend changes
    [CLK.sch, ProgramLogic.sch, Registers.sch, Registers_ALU.sch, S3_Schematic.sch]
2021-10-25 Schematic Done
    [ALU.sch, CLK-ProgramLogic.sch, CLK.sch, Capacitors.sch, Digikey 3.3v parts.xlsx, GPIO.sch, LEDS.sch, Memory.sch]
2021-11-12 Circuit Board Drafted (it could probably be improved)
    [4Layer.kicad_pcb, ALU.sch, Big_Board_Routed.kicad_pcb, BootFlash.sch, Digikey 3.3v parts.xlsx, First Rote Attempt.kicad_pcb, GPIO.sch, Memory.sch]
